revk/ESP32-EnvMon/PCB/Env2/README.md

# EnvMon

These files are for use in [KiCad](https://www.kicad.org).

## Trademark

This is an open source project, but bear in mind you cannot sell boards bearing the Andrews & Arnold Ltd name, the A&A logo, the registered trademark AJK logo, or the GS1 allocated EANs assigned to Andrews & Arnold Ltd.

## Images

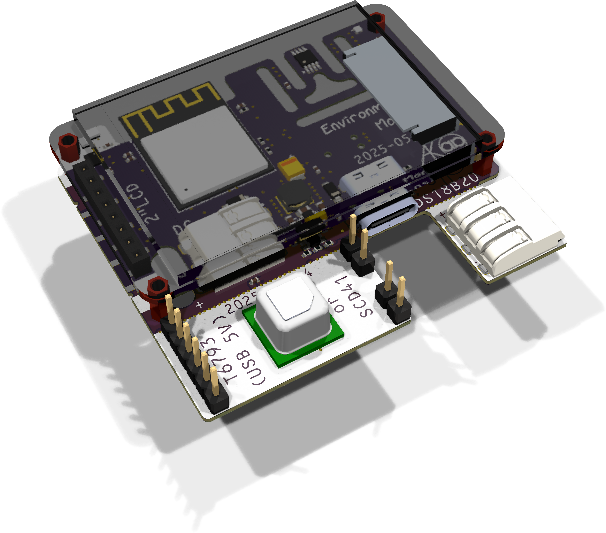
[picture p1: PCB/Env2/EnvMon.png]
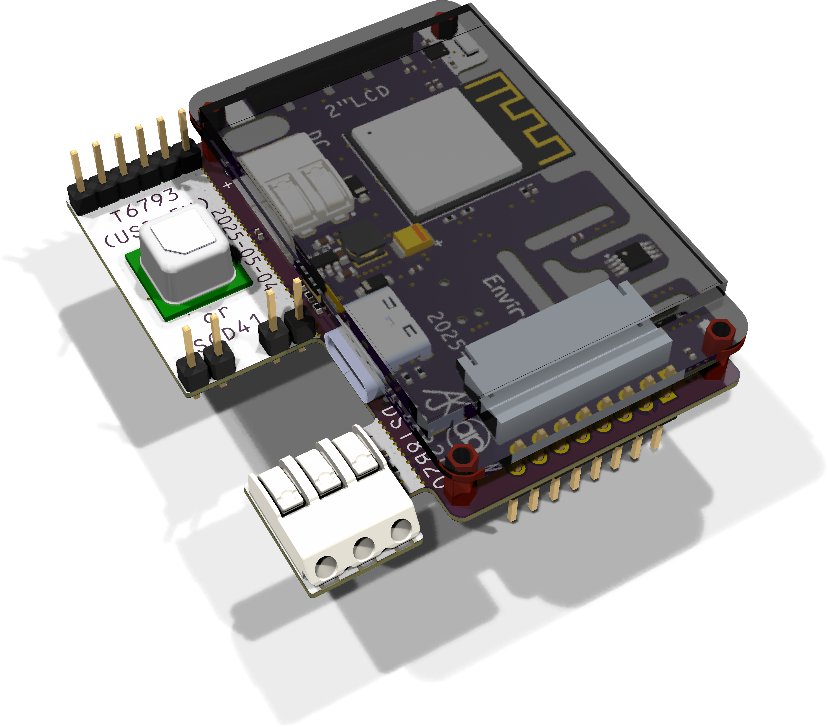
[picture p2: PCB/Env2/EnvMon-90.png]
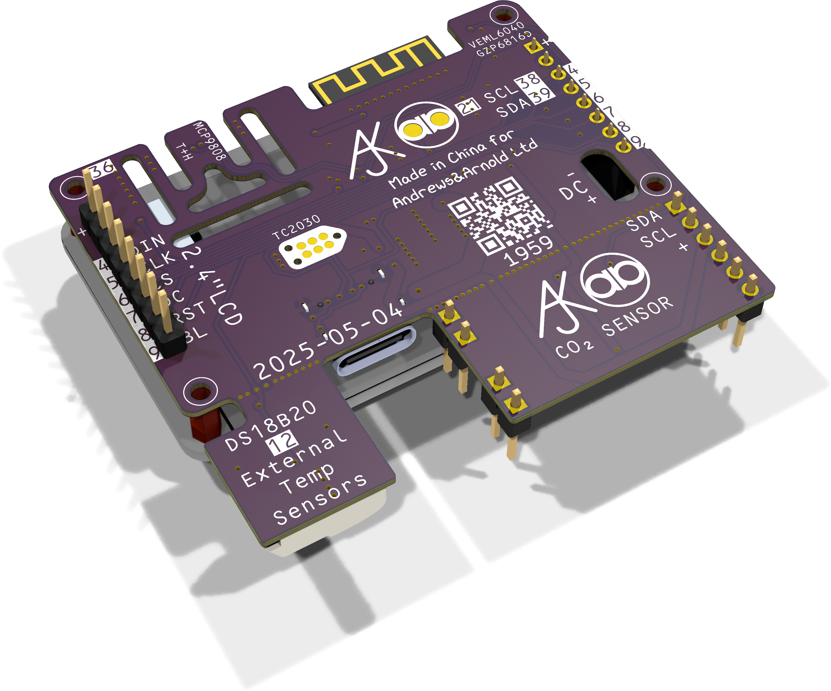
[picture p3: PCB/Env2/EnvMon-bottom.png]

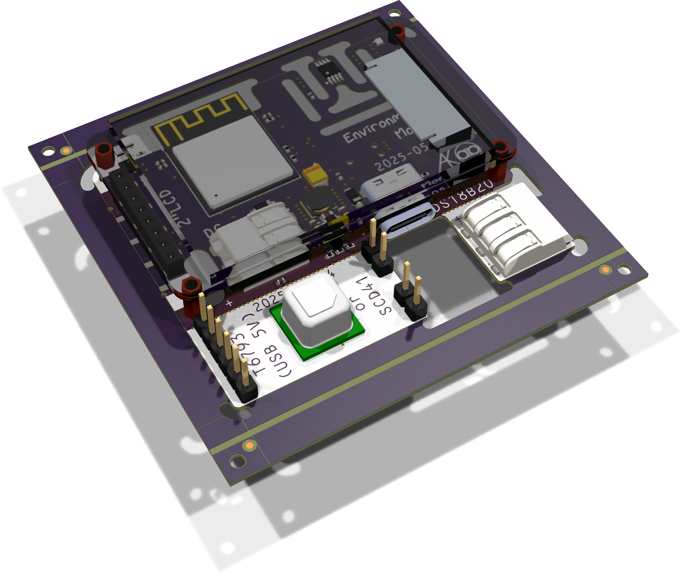
[picture p4: PCB/Env2/EnvMon-panel.png]
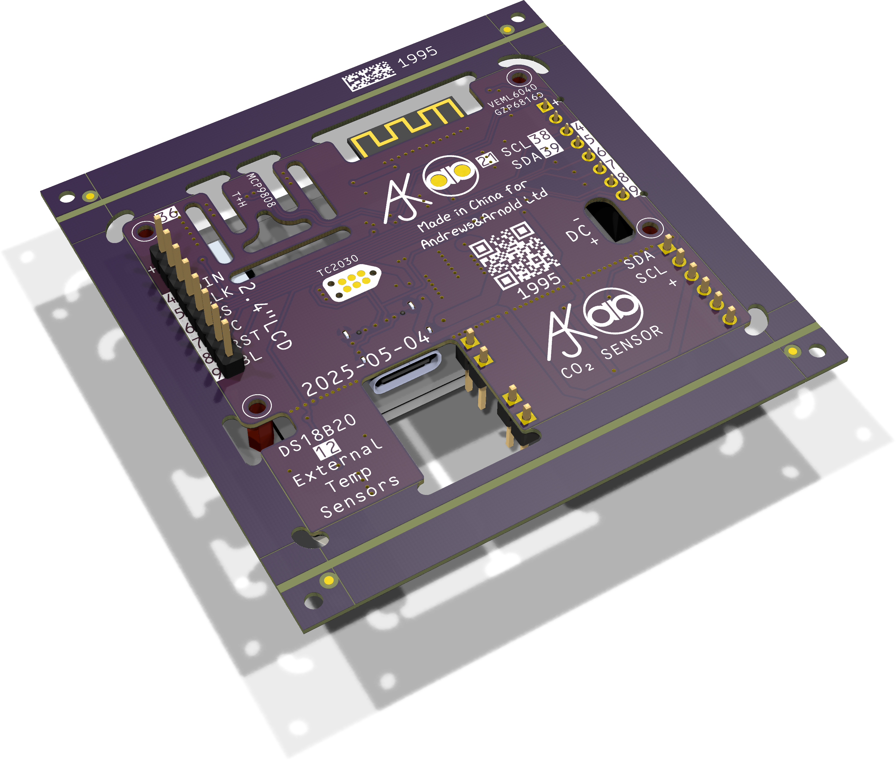
[picture p5: PCB/Env2/EnvMon-panel-bottom.png]


*Auto generated 2025-05-04T08:00:31*
