revk/ESP32-EnvMon/PCB/EnvHT/README.md

# EnvHT

These files are for use in [KiCad](https://www.kicad.org).

## Trademark

This is an open source project, but bear in mind you cannot sell boards bearing the Andrews & Arnold Ltd name, the A&A logo, the registered trademark AJK logo, or the GS1 allocated EANs assigned to Andrews & Arnold Ltd.

## Images

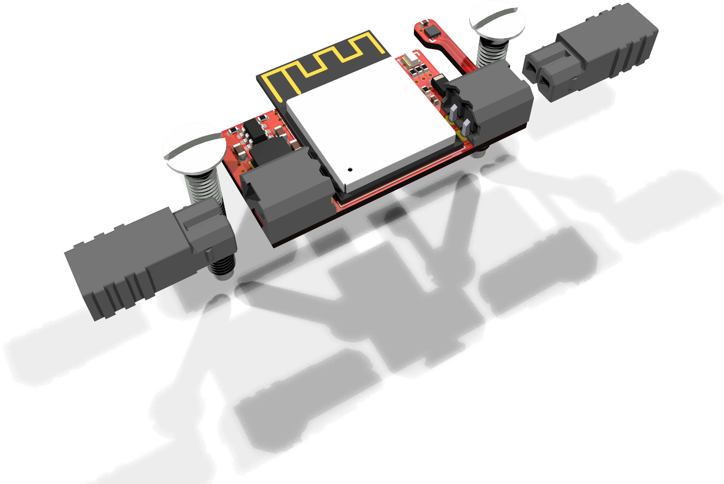
[picture p6: PCB/EnvHT/EnvHT.png]
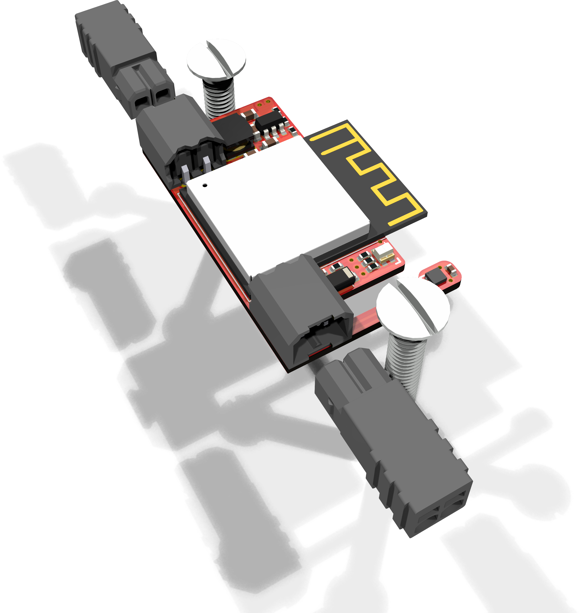
[picture p7: PCB/EnvHT/EnvHT-90.png]
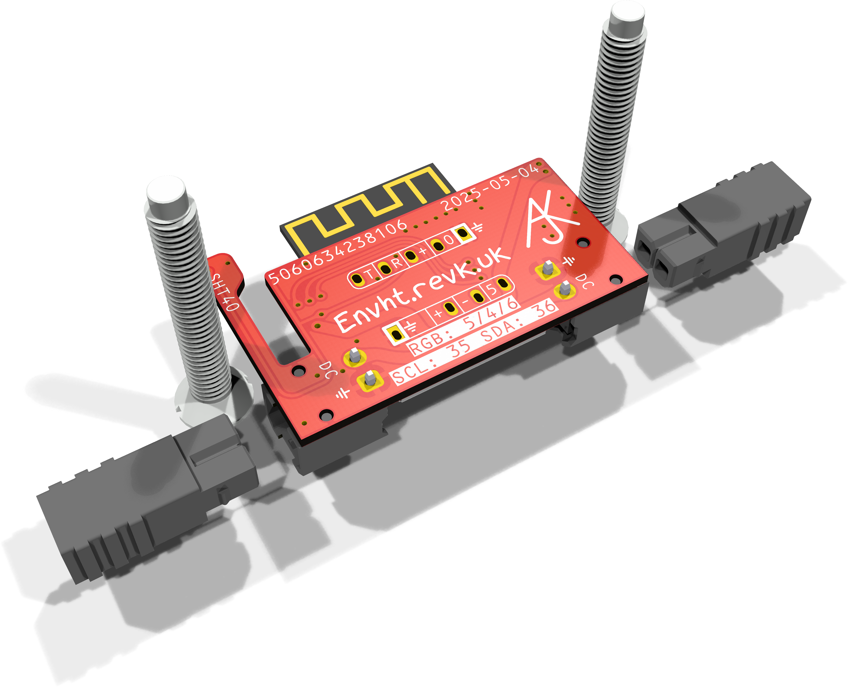
[picture p8: PCB/EnvHT/EnvHT-bottom.png]

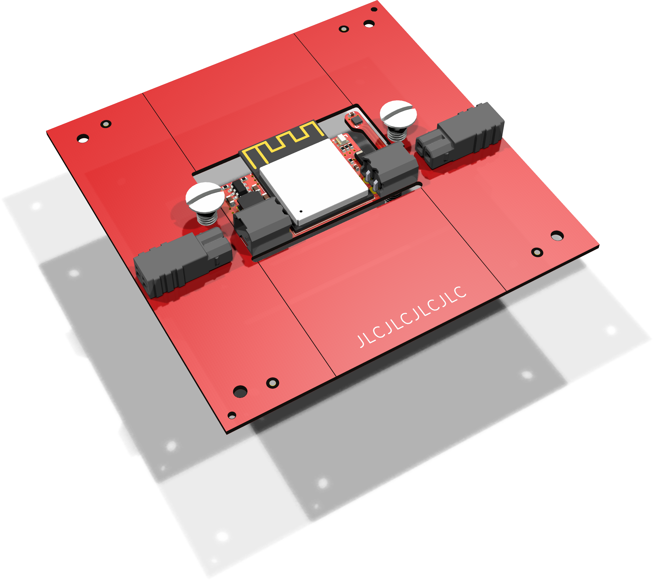
[picture p9: PCB/EnvHT/EnvHT-panel.png]
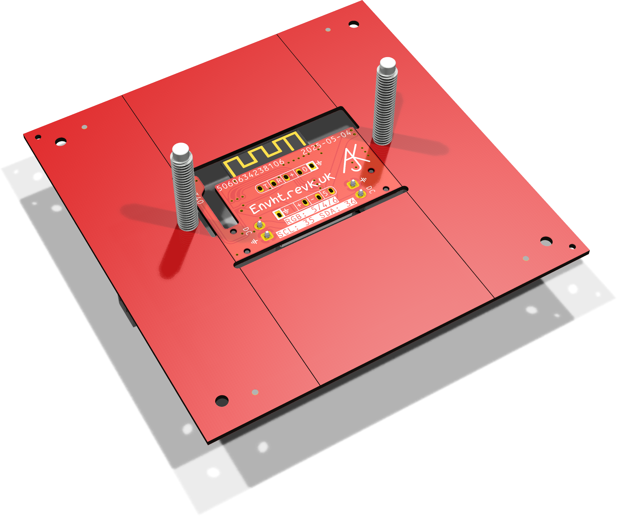
[picture p10: PCB/EnvHT/EnvHT-panel-bottom.png]


*Auto generated 2025-05-04T08:03:03*
