revk/ESP32-EnvMon/PCB/EnvMon/README.md

# EnvMon

These files are for use in [KiCad](https://www.kicad.org).

## Trademark

This is an open source project, but bear in mind you cannot sell boards bearing the Andrews & Arnold Ltd name, the A&A logo, the registered trademark AJK logo, or the GS1 allocated EANs assigned to Andrews & Arnold Ltd.

## Images

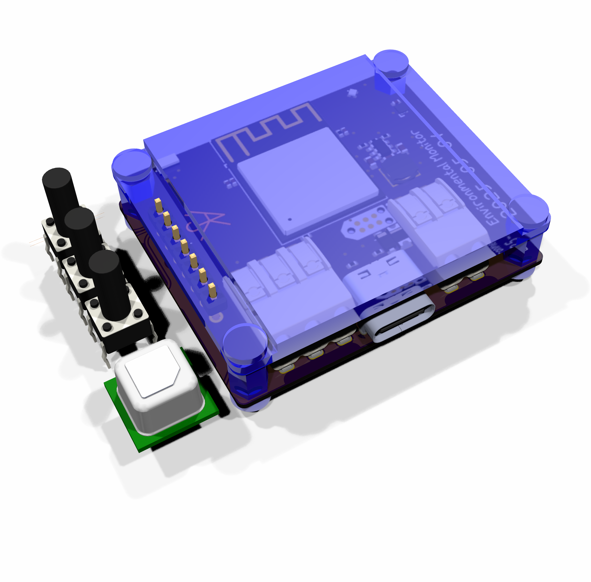
[picture p11: PCB/EnvMon/EnvMon.png]
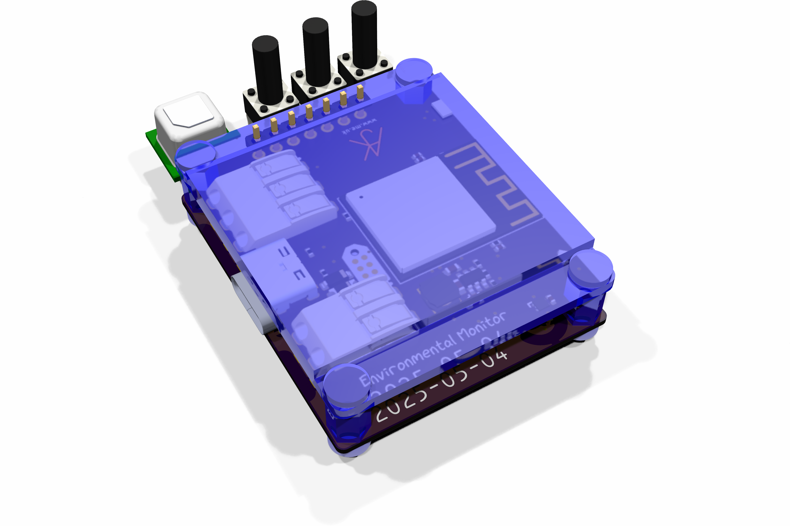
[picture p12: PCB/EnvMon/EnvMon-90.png]

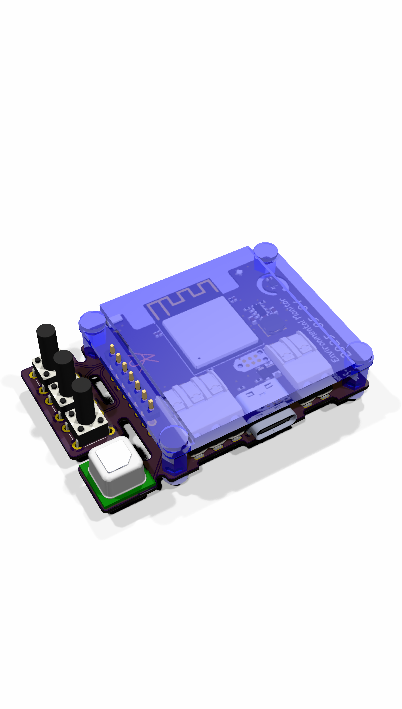
[picture p13: PCB/EnvMon/EnvMon-panel.png]


*Auto generated 2025-05-04T08:05:16*
