revk/ESP32-EnvMon/PCB/Env2/EnvMon.stl

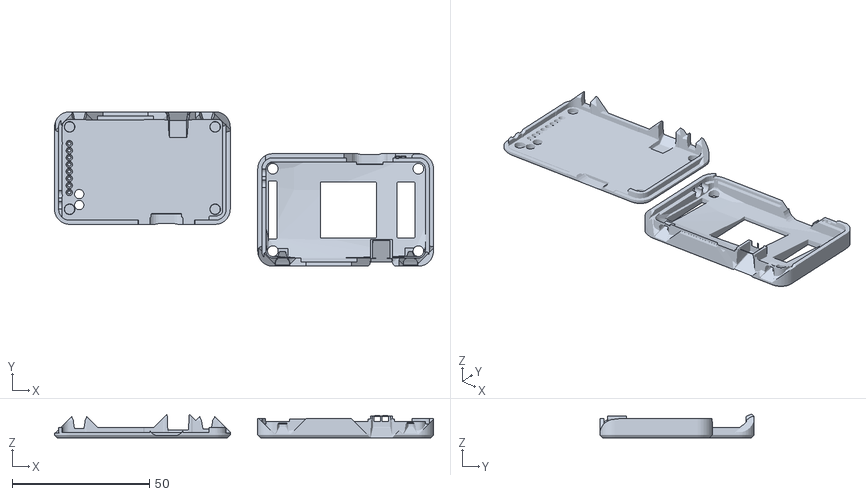
[picture p20: CAD file, 2025-05-06]
PCB/Env2/EnvMon.stl
138.0 x 56.2 x 8.59
