revk/ESP32-EnvMon/PCB/EnvHT/EnvHT.stl

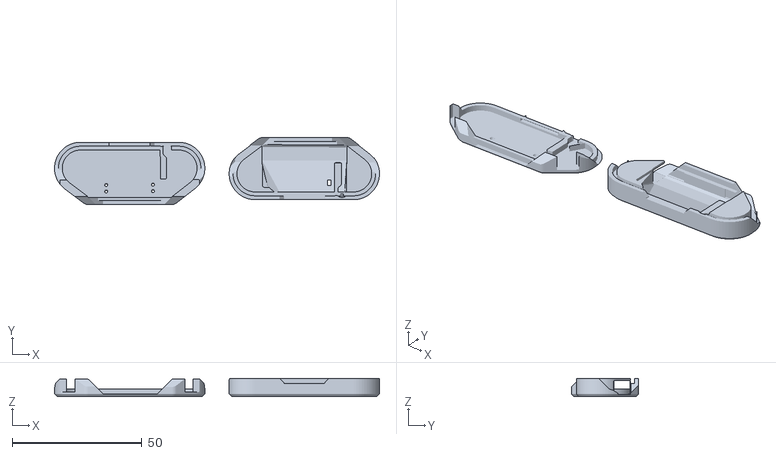
[picture p21: CAD file, 2025-05-06]
PCB/EnvHT/EnvHT.stl
125.3 x 25.9 x 6.99
