revk/ESP32-EnvMon/PCB/EnvMon/EnvMon-flush.stl

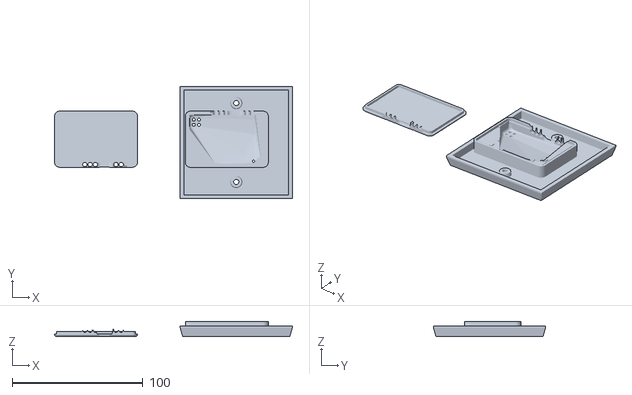
[picture p22: CAD file, 2025-05-06]
PCB/EnvMon/EnvMon-flush.stl
182.0 x 86.0 x 11.4
