revk/ESP32-EnvMon/PCB/USBC/USBC.stl

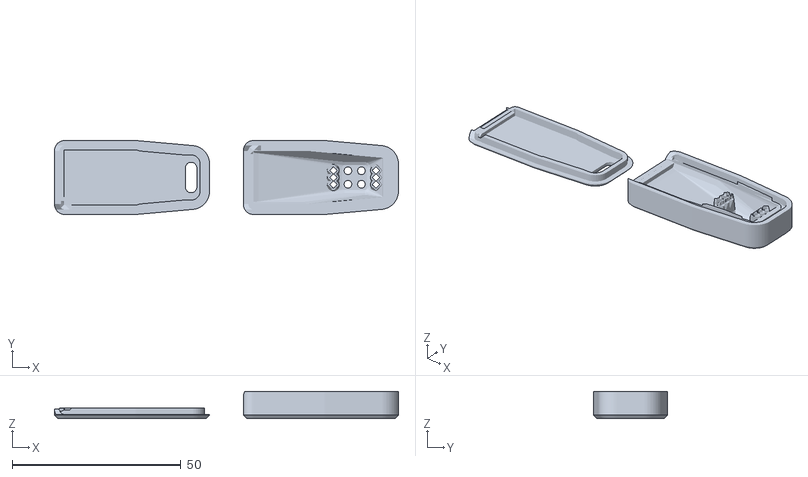
[picture p23: CAD file, 2025-05-06]
PCB/USBC/USBC.stl
102.0 x 21.9 x 8.06
