revk/ESP32-EnvMon/PCB/Env2-BP24.stl

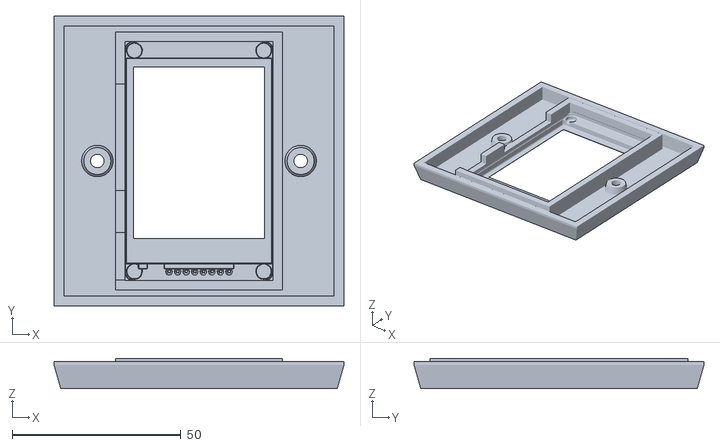
[picture p24: CAD file, 2025-05-06]
PCB/Env2-BP24.stl
86.0 x 86.0 x 9.00
