revk/ESP32-EnvMon/PCB/Env2/EnvMonBlind.stl

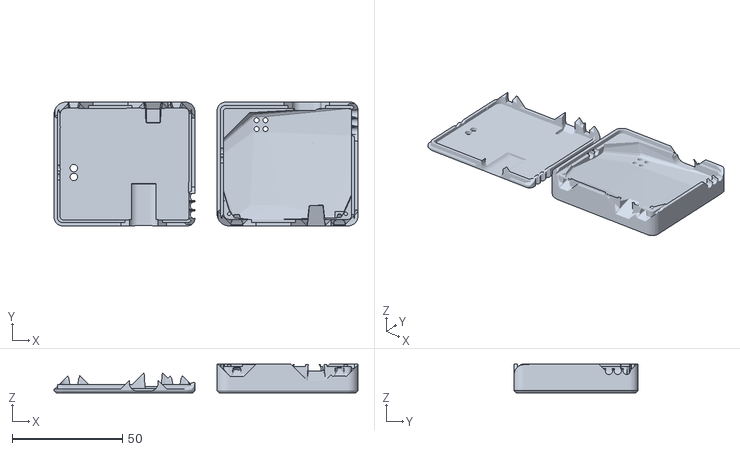
[picture p25: CAD file, 2025-05-06]
PCB/Env2/EnvMonBlind.stl
138.0 x 56.2 x 13.0
