revk/ESP32-EnvMon/PCB/EnvMon/EnvMon-noco2.stl

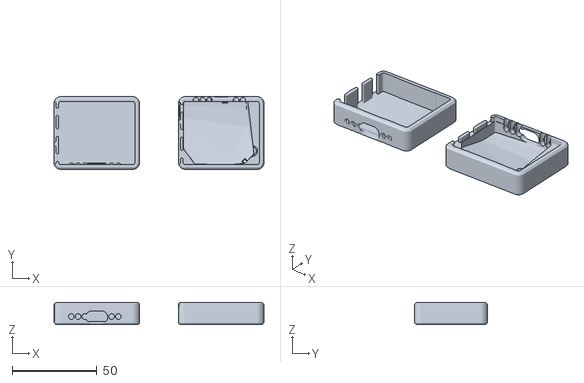
[picture p26: CAD file, 2025-05-06]
PCB/EnvMon/EnvMon-noco2.stl
124.0 x 43.0 x 13.2
