revk/ESP32-EnvMon/PCB/Env2-BP.stl

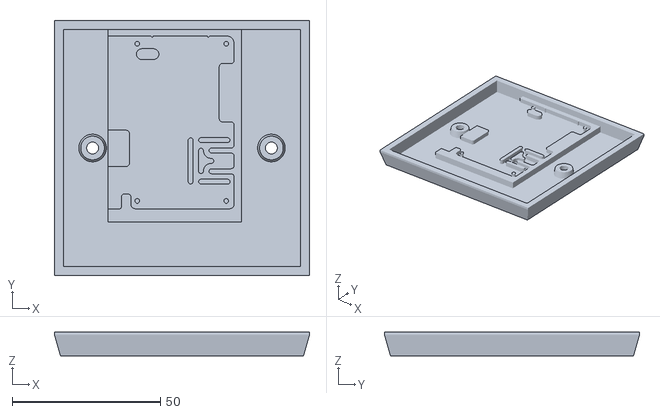
[picture p27: CAD file, 2025-05-06]
PCB/Env2-BP.stl
86.0 x 86.0 x 8.00
