revk/ESP32-EnvMon/PCB/Env2/EnvMonCO2.stl

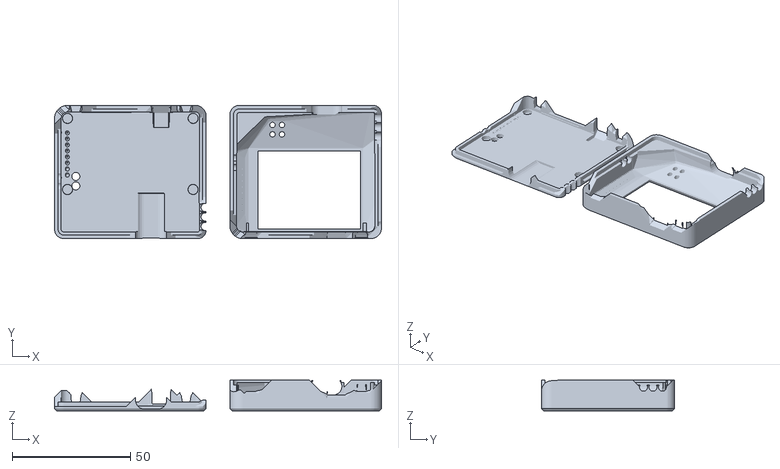
[picture p28: CAD file, 2025-05-06]
PCB/Env2/EnvMonCO2.stl
138.0 x 56.2 x 13.0
