revk/ESP32-EnvMon/PCB/EnvMon/EnvMon.stl

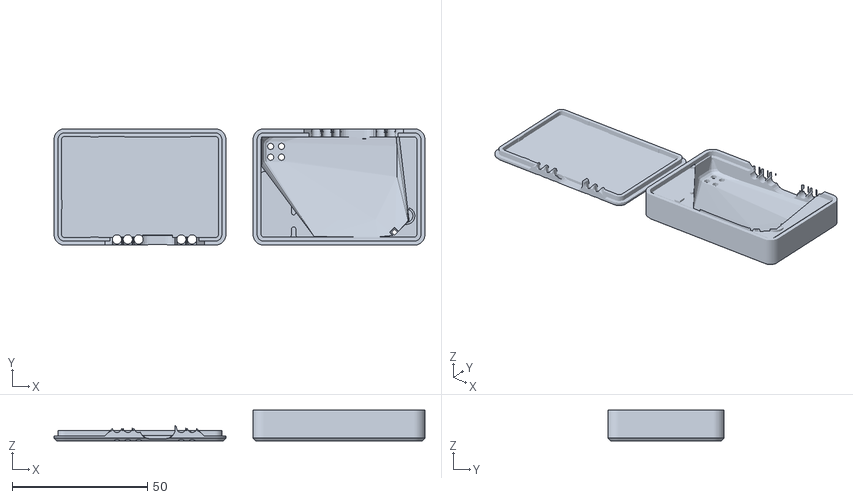
[picture p29: CAD file, 2025-05-06]
PCB/EnvMon/EnvMon.stl
137.0 x 43.0 x 11.4
