revk/ESP32-EnvMon/PCB/EnvMon/EnvMon-nooled.stl

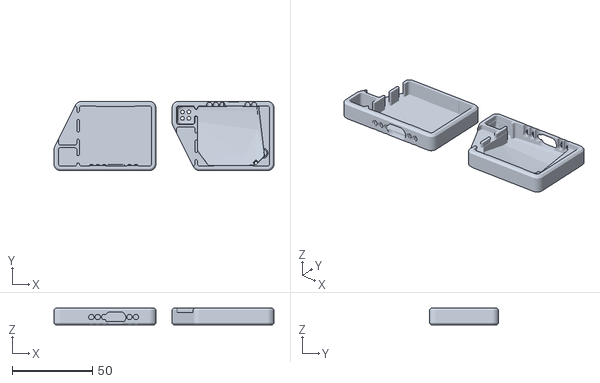
[picture p30: CAD file, 2025-05-06]
PCB/EnvMon/EnvMon-nooled.stl
137.0 x 43.0 x 10.3
