revk/ESP32-EnvMon/PCB/EnvMon/EnvMon-flush-nooled.stl

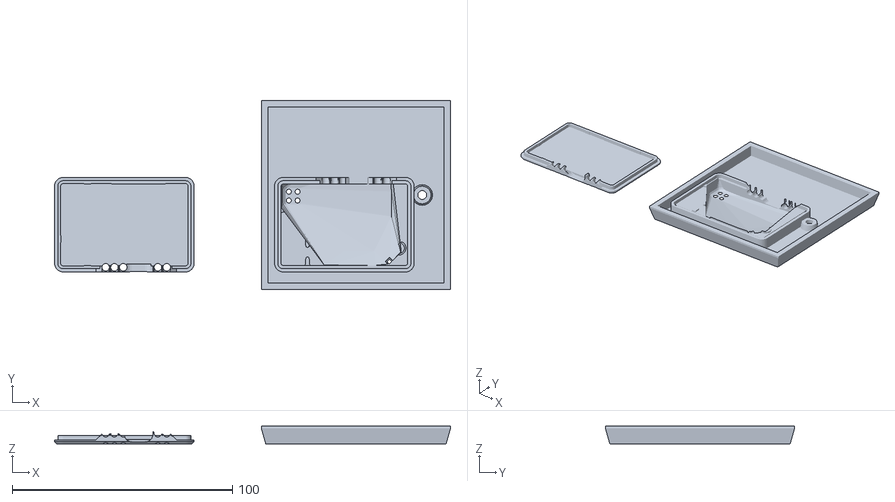
[picture p31: CAD file, 2025-05-06]
PCB/EnvMon/EnvMon-flush-nooled.stl
180.0 x 86.0 x 8.00
