revk/ESP32-EnvMon/PCB/Env2-CoverDS.stl

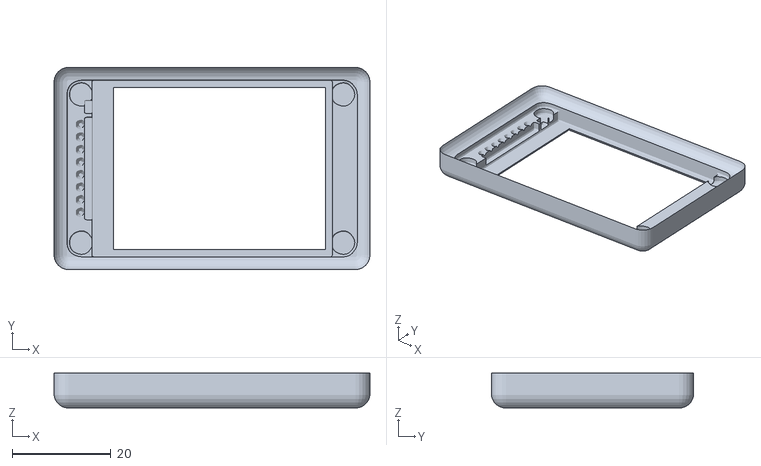
[picture p32: CAD file, 2025-05-03]
PCB/Env2-CoverDS.stl
63.9 x 40.9 x 7.08
