revk/ESP32-EnvMon/PCB/EnvMon/EnvMon-flush-noco2.stl

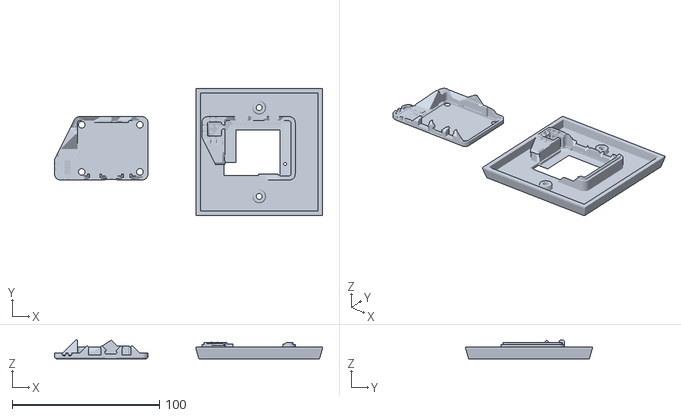
[picture p33: CAD file, 2023-12-11]
PCB/EnvMon/EnvMon-flush-noco2.stl
182.0 x 86.0 x 12.8
