revk/ESP32-EnvMon/PCB/Env2-CoverCO2.stl

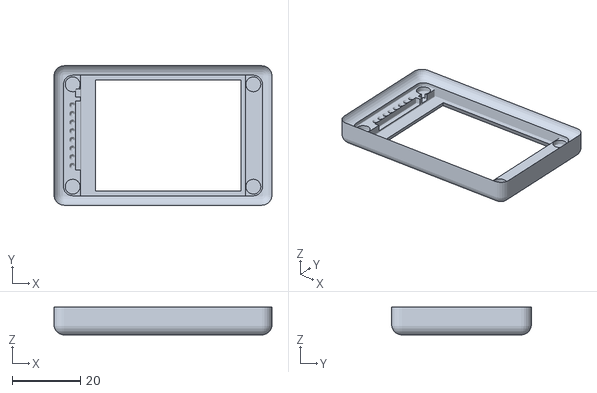
[picture p34: CAD file, 2025-05-03]
PCB/Env2-CoverCO2.stl
63.9 x 40.9 x 8.08
