revk/ESP32-EnvMon/PCB/lcd2.stl

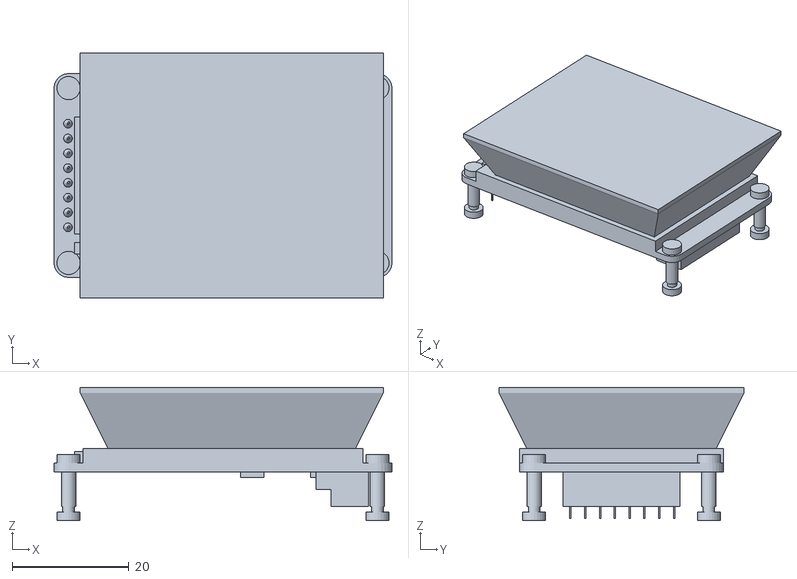
[picture p35: CAD file, 2025-05-02]
PCB/lcd2.stl
58.0 x 42.0 x 22.9
