revk/ESP32-EnvMon/PCB/Env2-Cover2.stl

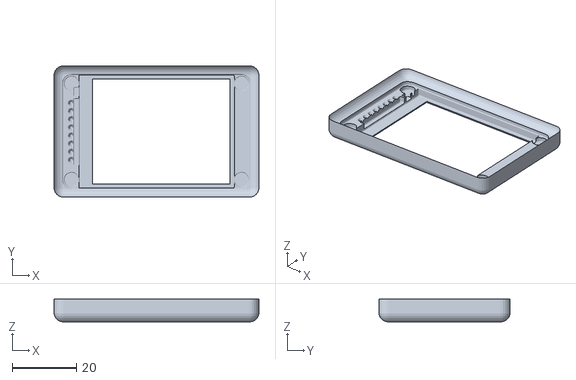
[picture p36: CAD file, 2025-04-28]
PCB/Env2-Cover2.stl
63.9 x 40.9 x 7.08
