revk/ESP32-EnvMon/PCB/lcd24.stl

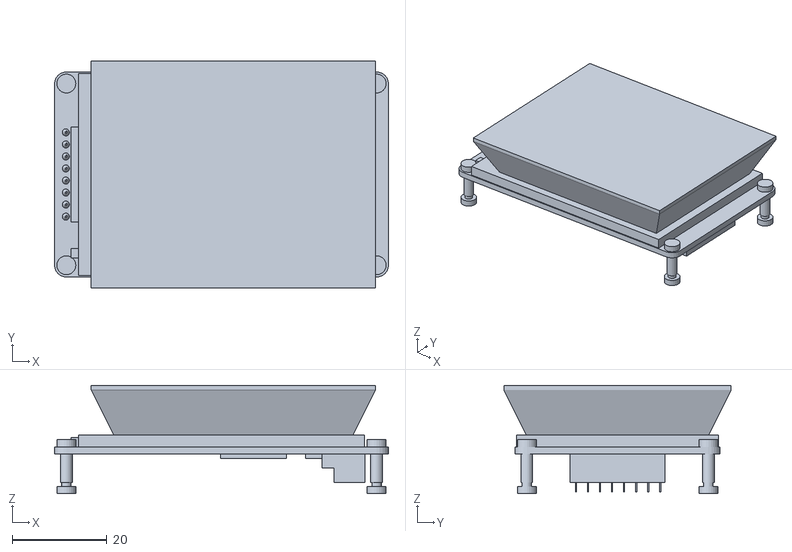
[picture p37: CAD file, 2025-04-27]
PCB/lcd24.stl
70.5 x 48.0 x 22.9
