revk/ESP32-EnvMon/PCB/blankplate.stl

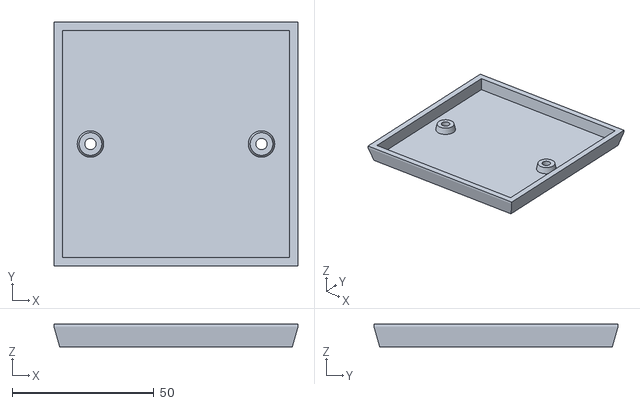
[picture p38: CAD file, 2025-04-27]
PCB/blankplate.stl
86.0 x 86.0 x 8.00
