revk/ESP32-EnvMon/PCB/Env2/EnvMon.scad

// Generated case design for Env2/EnvMon.kicad_pcb
// By https://github.com/revk/PCBCase
// Generated 2025-05-05 10:25:44
// title:	Env2
// comment:	www.me.uk
// comment:	@TheRealRevK
// comment:	Adrian Kennard Andrews & Arnold Ltd
//

// Globals
margin=0.200000;
lip=2.000000;
casebottom=2.000000;
casetop=6.000000;
casewall=3.000000;
fit=0.000000;
edge=1.000000;
pcbthickness=0.800000;
nohull=false;
hullcap=1.000000;
hulledge=1.000000;
useredge=true;

module outline(h=pcbthickness,r=0){linear_extrude(height=h)offset(r=r)polygon(points=[[0.000000,47.750000],[0.000000,17.750000],[0.062680,17.193698],[0.247578,16.665291],[0.545421,16.191275],[0.941275,15.795421],[1.415291,15.497578],[1.943698,15.312680],[2.500000,15.250000],[55.500000,15.250000],[56.056302,15.312680],[56.584709,15.497578],[57.058725,15.795421],[57.454579,16.191275],[57.752422,16.665291],[57.937320,17.193698],[58.000000,17.750000],[58.000000,47.750000],[57.937320,48.306302],[57.752422,48.834709],[57.454579,49.308725],[57.058725,49.704579],[56.584709,50.002422],[56.056302,50.187320],[55.500000,50.250000],[2.500000,50.250000],[1.943698,50.187320],[1.415291,50.002422],[0.941275,49.704579],[0.545421,49.308725],[0.247578,48.834709],[0.062680,48.306302]],paths=[[0,1,2,3,4,5,6,7,8,9,10,11,12,13,14,15,16,17,18,19,20,21,22,23,24,25,26,27,28,29,30,31]]);}

module pcb(h=pcbthickness,r=0){linear_extrude(height=h)offset(r=r)polygon(points=[[58.000000,17.250000],[58.000000,48.750000],[57.926585,49.213525],[57.713525,49.631678],[57.381678,49.963525],[56.963525,50.176585],[56.500000,50.250000],[47.500000,50.250000],[47.117316,50.173880],[46.792893,49.957107],[46.576120,49.632684],[46.500000,49.250000],[46.500000,42.750000],[46.465926,42.491181],[46.366025,42.250000],[46.207107,42.042893],[46.000000,41.883975],[45.758819,41.784074],[45.500000,41.750000],[45.241181,41.784074],[45.000000,41.883975],[44.792893,42.042893],[44.633975,42.250000],[44.534074,42.491181],[44.500000,42.750000],[44.500000,49.250000],[44.423880,49.632684],[44.207107,49.957107],[43.882684,50.173880],[43.500000,50.250000],[40.500000,50.250000],[40.117316,50.173880],[39.792893,49.957107],[39.576120,49.632684],[39.500000,49.250000],[39.500000,42.750000],[39.465926,42.491181],[39.366025,42.250000],[39.207107,42.042893],[39.000000,41.883975],[38.758819,41.784074],[38.500000,41.750000],[38.241181,41.784074],[38.000000,41.883975],[37.792893,42.042893],[37.633975,42.250000],[37.534074,42.491181],[37.500000,42.750000],[37.500000,49.250000],[37.423880,49.632684],[37.207107,49.957107],[36.882684,50.173880],[36.500000,50.250000],[30.000000,50.250000],[29.617316,50.173880],[29.292893,49.957107],[29.076120,49.632684],[29.000000,49.250000],[29.000000,46.250000],[28.965926,45.991181],[28.866026,45.750000],[28.707107,45.542893],[28.500000,45.383974],[28.258819,45.284074],[28.000000,45.250000],[10.000000,45.250000],[9.741181,45.284074],[9.500000,45.383974],[9.292893,45.542893],[9.133974,45.750000],[9.034074,45.991181],[9.000000,46.250000],[9.000000,49.250000],[8.923880,49.632684],[8.707107,49.957107],[8.382684,50.173880],[8.000000,50.250000],[2.500000,50.250000],[1.943698,50.187320],[1.415291,50.002422],[0.941275,49.704579],[0.545421,49.308725],[0.247578,48.834709],[0.062680,48.306302],[0.000000,47.750000],[0.000000,42.250000],[0.191342,42.211940],[0.353553,42.103553],[0.461940,41.941342],[0.500000,41.750000],[0.461940,41.558658],[0.353553,41.396447],[0.191342,41.288060],[0.000000,41.250000],[0.000000,23.250000],[0.191342,23.211940],[0.353553,23.103553],[0.461940,22.941342],[0.500000,22.750000],[0.461940,22.558658],[0.353553,22.396447],[0.191342,22.288060],[0.000000,22.250000],[0.000000,1.000000],[0.076120,0.617316],[0.292893,0.292893],[0.617316,0.076120],[1.000000,0.000000],[31.000000,0.000000],[31.353553,0.146447],[31.500000,0.500000],[31.500000,14.250000],[31.534074,14.508819],[31.633974,14.750000],[31.792893,14.957107],[32.000000,15.116026],[32.241181,15.215926],[32.500000,15.250000],[43.000000,15.250000],[43.258819,15.215926],[43.500000,15.116026],[43.707107,14.957107],[43.866026,14.750000],[43.965926,14.508819],[44.000000,14.250000],[44.000000,0.500000],[44.146447,0.146447],[44.500000,0.000000],[57.500000,0.000000],[57.853553,0.146447],[58.000000,0.500000],[58.000000,11.750000],[57.853553,12.103553],[57.500000,12.250000],[54.000000,12.250000],[53.741181,12.284074],[53.500000,12.383974],[53.292893,12.542893],[53.133974,12.750000],[53.034074,12.991181],[53.000000,13.250000],[53.000000,14.750000],[53.034074,15.008819],[53.133974,15.250000],[53.292893,15.457107],[53.500000,15.616026],[53.741181,15.715926],[54.000000,15.750000],[56.500000,15.750000],[56.963525,15.823415],[57.381678,16.036475],[57.713525,16.368322],[57.926585,16.786475],[56.500000,17.750000],[56.465926,17.491181],[56.366025,17.250000],[56.207107,17.042893],[56.000000,16.883975],[55.758819,16.784074],[55.500000,16.750000],[55.241181,16.784074],[55.000000,16.883975],[54.792893,17.042893],[54.633975,17.250000],[54.534074,17.491181],[54.500000,17.750000],[54.534074,18.008819],[54.633975,18.250000],[54.792893,18.457107],[55.000000,18.616025],[55.241181,18.715926],[55.500000,18.750000],[55.758819,18.715926],[56.000000,18.616025],[56.207107,18.457107],[56.366025,18.250000],[56.465926,18.008819],[49.000000,34.750000],[49.309017,34.798943],[49.587785,34.940983],[49.809017,35.162215],[49.951057,35.440983],[50.000000,35.750000],[49.951057,36.059017],[49.809017,36.337785],[49.587785,36.559017],[49.309017,36.701057],[49.000000,36.750000],[35.000000,36.750000],[34.690983,36.701057],[34.412215,36.559017],[34.190983,36.337785],[34.048943,36.059017],[34.000000,35.750000],[34.048943,35.440983],[34.190983,35.162215],[34.412215,34.940983],[34.690983,34.798943],[35.000000,34.750000],[48.000000,39.250000],[48.000000,48.250000],[48.034074,48.508819],[48.133975,48.750000],[48.292893,48.957107],[48.500000,49.116025],[48.741181,49.215926],[49.000000,49.250000],[49.258819,49.215926],[49.500000,49.116025],[49.707107,48.957107],[49.866025,48.750000],[49.965926,48.508819],[50.000000,48.250000],[50.000000,39.250000],[49.965926,38.991181],[49.866025,38.750000],[49.707107,38.542893],[49.500000,38.383975],[49.258819,38.284074],[49.000000,38.250000],[48.741181,38.284074],[48.500000,38.383975],[48.292893,38.542893],[48.133975,38.750000],[48.034074,38.991181],[45.500000,38.250000],[38.500000,38.250000],[38.241181,38.284074],[38.000000,38.383975],[37.792893,38.542893],[37.633975,38.750000],[37.534074,38.991181],[37.500000,39.250000],[37.534074,39.508819],[37.633975,39.750000],[37.792893,39.957107],[38.000000,40.116025],[38.241181,40.215926],[38.500000,40.250000],[39.056302,40.312680],[39.584709,40.497578],[40.058725,40.795421],[40.454579,41.191275],[40.752422,41.665291],[40.937320,42.193698],[41.000000,42.750000],[41.034074,43.008819],[41.133975,43.250000],[41.292893,43.457107],[41.500000,43.616025],[41.741181,43.715926],[42.000000,43.750000],[42.258819,43.715926],[42.500000,43.616025],[42.707107,43.457107],[42.866025,43.250000],[42.965926,43.008819],[43.000000,42.750000],[43.062680,42.193698],[43.247578,41.665291],[43.545421,41.191275],[43.941275,40.795421],[44.415291,40.497578],[44.943698,40.312680],[45.500000,40.250000],[45.758819,40.215926],[46.000000,40.116025],[46.207107,39.957107],[46.366025,39.750000],[46.465926,39.508819],[46.500000,39.250000],[46.465926,38.991181],[46.366025,38.750000],[46.207107,38.542893],[46.000000,38.383975],[45.758819,38.284074],[36.000000,39.250000],[36.000000,48.250000],[35.951057,48.559017],[35.809017,48.837785],[35.587785,49.059017],[35.309017,49.201057],[35.000000,49.250000],[34.690983,49.201057],[34.412215,49.059017],[34.190983,48.837785],[34.048943,48.559017],[34.000000,48.250000],[34.000000,39.250000],[34.048943,38.940983],[34.190983,38.662215],[34.412215,38.440983],[34.690983,38.298943],[35.000000,38.250000],[35.309017,38.298943],[35.587785,38.440983],[35.809017,38.662215],[35.951057,38.940983],[54.500000,47.750000],[54.534074,48.008819],[54.633975,48.250000],[54.792893,48.457107],[55.000000,48.616025],[55.241181,48.715926],[55.500000,48.750000],[55.758819,48.715926],[56.000000,48.616025],[56.207107,48.457107],[56.366025,48.250000],[56.465926,48.008819],[56.500000,47.750000],[56.465926,47.491181],[56.366025,47.250000],[56.207107,47.042893],[56.000000,46.883975],[55.758819,46.784074],[55.500000,46.750000],[55.241181,46.784074],[55.000000,46.883975],[54.792893,47.042893],[54.633975,47.250000],[54.534074,47.491181],[3.500000,47.750000],[3.465926,47.491181],[3.366025,47.250000],[3.207107,47.042893],[3.000000,46.883975],[2.758819,46.784074],[2.500000,46.750000],[2.241181,46.784074],[2.000000,46.883975],[1.792893,47.042893],[1.633975,47.250000],[1.534074,47.491181],[1.500000,47.750000],[1.534074,48.008819],[1.633975,48.250000],[1.792893,48.457107],[2.000000,48.616025],[2.241181,48.715926],[2.500000,48.750000],[2.758819,48.715926],[3.000000,48.616025],[3.207107,48.457107],[3.366025,48.250000],[3.465926,48.008819],[4.000000,23.250000],[4.000000,19.250000],[4.050144,18.804958],[4.198062,18.382233],[4.436337,18.003020],[4.753020,17.686337],[5.132233,17.448062],[5.554958,17.300144],[6.000000,17.250000],[6.445042,17.300144],[6.867767,17.448062],[7.246980,17.686337],[7.563663,18.003020],[7.801938,18.382233],[7.949856,18.804958],[8.000000,19.250000],[8.000000,23.250000],[7.949856,23.695042],[7.801938,24.117767],[7.563663,24.496980],[7.246980,24.813663],[6.867767,25.051938],[6.445042,25.199856],[6.000000,25.250000],[5.554958,25.199856],[5.132233,25.051938],[4.753020,24.813663],[4.436337,24.496980],[4.198062,24.117767],[4.050144,23.695042],[3.500000,17.750000],[3.465926,17.491181],[3.366025,17.250000],[3.207107,17.042893],[3.000000,16.883975],[2.758819,16.784074],[2.500000,16.750000],[2.241181,16.784074],[2.000000,16.883975],[1.792893,17.042893],[1.633975,17.250000],[1.534074,17.491181],[1.500000,17.750000],[1.534074,18.008819],[1.633975,18.250000],[1.792893,18.457107],[2.000000,18.616025],[2.241181,18.715926],[2.500000,18.750000],[2.758819,18.715926],[3.000000,18.616025],[3.207107,18.457107],[3.366025,18.250000],[3.465926,18.008819]],paths=[[0,1,2,3,4,5,6,7,8,9,10,11,12,13,14,15,16,17,18,19,20,21,22,23,24,25,26,27,28,29,30,31,32,33,34,35,36,37,38,39,40,41,42,43,44,45,46,47,48,49,50,51,52,53,54,55,56,57,58,59,60,61,62,63,64,65,66,67,68,69,70,71,72,73,74,75,76,77,78,79,80,81,82,83,84,85,86,87,88,89,90,91,92,93,94,95,96,97,98,99,100,101,102,103,104,105,106,107,108,109,110,111,112,113,114,115,116,117,118,119,120,121,122,123,124,125,126,127,128,129,130,131,132,133,134,135,136,137,138,139,140,141,142,143,144,145,146,147,148,149,150,151,152],[153,154,155,156,157,158,159,160,161,162,163,164,165,166,167,168,169,170,171,172,173,174,175,176],[177,178,179,180,181,182,183,184,185,186,187,188,189,190,191,192,193,194,195,196,197,198],[199,200,201,202,203,204,205,206,207,208,209,210,211,212,213,214,215,216,217,218,219,220,221,222,223,224],[225,226,227,228,229,230,231,232,233,234,235,236,237,238,239,240,241,242,243,244,245,246,247,248,249,250,251,252,253,254,255,256,257,258,259,260,261,262,263,264,265,266,267,268,269,270,271,272,273,274,275],[276,277,278,279,280,281,282,283,284,285,286,287,288,289,290,291,292,293,294,295,296,297],[298,299,300,301,302,303,304,305,306,307,308,309,310,311,312,313,314,315,316,317,318,319,320,321],[322,323,324,325,326,327,328,329,330,331,332,333,334,335,336,337,338,339,340,341,342,343,344,345],[346,347,348,349,350,351,352,353,354,355,356,357,358,359,360,361,362,363,364,365,366,367,368,369,370,371,372,373,374,375],[376,377,378,379,380,381,382,383,384,385,386,387,388,389,390,391,392,393,394,395,396,397,398,399]]);}
spacing=74.000000;
pcbwidth=58.000000;
pcblength=50.250000;
// Parts to go on PCB (top)
module parts_top(part=false,hole=false,block=false){
translate([54.500000,45.250000,0.800000])m0(part,hole,block,casetop); // RevK:C_0402 C_0402_1005Metric (back)
translate([28.300000,16.800000,0.800000])rotate([0,0,180.000000])m1(part,hole,block,casetop); // RevK:R_0402_ R_0402_1005Metric (back)
translate([43.500000,18.750000,0.800000])m1(part,hole,block,casetop); // RevK:R_0402_ R_0402_1005Metric (back)
translate([24.699999,16.800000,0.800000])rotate([0,0,180.000000])m1(part,hole,block,casetop); // RevK:R_0402_ R_0402_1005Metric (back)
translate([29.000000,20.000000,0.800000])rotate([0,0,-90.000000])m2(part,hole,block,casetop); // RevK:C_0603_ C_0603_1608Metric (back)
translate([6.000000,48.750000,0.800000])m3(part,hole,block,casetop); // U8 (back)
translate([28.500000,43.250000,0.800000])m0(part,hole,block,casetop); // RevK:C_0402 C_0402_1005Metric (back)
translate([3.000000,45.250000,0.800000])rotate([0,0,-90.000000])m0(part,hole,block,casetop); // RevK:C_0402 C_0402_1005Metric (back)
translate([9.500000,42.750000,0.800000])rotate([0,0,180.000000])m0(part,hole,block,casetop); // RevK:C_0402 C_0402_1005Metric (back)
translate([28.500000,42.250000,0.800000])rotate([0,0,180.000000])m1(part,hole,block,casetop); // RevK:R_0402_ R_0402_1005Metric (back)
translate([27.750000,35.500000,0.800000])rotate([0,0,-90.000000])m1(part,hole,block,casetop); // RevK:R_0402_ R_0402_1005Metric (back)
translate([24.000000,20.000000,0.800000])rotate([0,0,-90.000000])m2(part,hole,block,casetop); // RevK:C_0603_ C_0603_1608Metric (back)
translate([7.700000,45.850000,0.800000])rotate([0,0,180.000000])m0(part,hole,block,casetop); // RevK:C_0402 C_0402_1005Metric (back)
translate([47.900000,13.550000,0.800000])rotate([0,0,180.000000])m0(part,hole,block,casetop); // RevK:C_0402 C_0402_1005Metric (back)
translate([29.000000,32.750000,0.800000])translate([-26.600000,8.890000,0.000000])scale([1.000000,1.000000,0.700000])m4(part,hole,block,casetop,08); // RevK:LCD2 PinSocket_1x08_P2.54mm_Vertical (back)
translate([29.000000,32.750000,0.800000])translate([-26.500000,15.000000,0.000000])m6(part,hole,block,casetop); // RevK:LCD2 M2x6Pillar (back)
translate([29.000000,32.750000,0.800000])translate([-26.500000,-15.000000,0.000000])m6(part,hole,block,casetop); // RevK:LCD2 M2x6Pillar (back)
translate([29.000000,32.750000,0.800000])translate([26.500000,15.000000,0.000000])m6(part,hole,block,casetop); // RevK:LCD2 M2x6Pillar (back)
translate([29.000000,32.750000,0.800000])translate([26.500000,-15.000000,0.000000])m6(part,hole,block,casetop); // RevK:LCD2 M2x6Pillar (back)
translate([29.000000,32.750000,0.800000])translate([22.000000,0.000000,0.000000])m7(part,hole,block,casetop); // RevK:LCD2 LCDHeader (back)
translate([9.500000,41.750000,0.800000])rotate([0,0,180.000000])m0(part,hole,block,casetop); // RevK:C_0402 C_0402_1005Metric (back)
translate([31.750000,21.750000,0.800000])rotate([0,0,90.000000])m8(part,hole,block,casetop); // D20 (back)
translate([26.500000,20.700000,0.800000])rotate([0,0,180.000000])m2(part,hole,block,casetop); // RevK:C_0603_ C_0603_1608Metric (back)
translate([16.000000,16.250000,0.800000])m0(part,hole,block,casetop); // RevK:C_0402 C_0402_1005Metric (back)
translate([50.550000,6.150000,0.800000])rotate([0,0,180.000000])m9(part,hole,block,casetop); // J3 (back)
translate([37.750000,21.250000,0.800000])translate([0.000000,-2.400000,0.000000])rotate([90.000000,-0.000000,-0.000000])m10(part,hole,block,casetop); // RevK:USB-C-Socket-H CSP-USC16-TR (back)
translate([28.700000,28.150000,0.800000])rotate([0,0,90.000000])m11(part,hole,block,casetop); // C4 (back)
translate([16.000000,21.250000,0.800000])m12(part,hole,block,casetop); // J2 (back)
translate([26.500000,18.700000,0.800000])rotate([0,0,180.000000])m13(part,hole,block,casetop); // RevK:SOT-23-6-MD8942 SOT-23-6 (back)
translate([50.000000,13.550000,0.800000])rotate([0,0,180.000000])m1(part,hole,block,casetop); // RevK:R_0402_ R_0402_1005Metric (back)
translate([5.000000,45.250000,0.800000])rotate([0,0,-90.000000])m14(part,hole,block,casetop); // U5 (back)
translate([26.500000,23.300000,0.800000])rotate([0,0,180.000000])scale([1.000000,1.000000,1.400000])rotate([0.000000,0.000000,-90.000000])m15(part,hole,block,casetop); // RevK:L_4x4_ TYA4020 (back)
translate([52.575000,48.675000,0.800000])m16(part,hole,block,casetop); // D4 (back)
translate([19.000000,37.250000,0.800000])m17(part,hole,block,casetop); // U1 (back)
translate([42.025000,47.000000,0.800000])rotate([0,0,90.000000])m18(part,hole,block,casetop); // U4 (back)
translate([19.000000,26.750000,0.800000])rotate([0,0,180.000000])m8(part,hole,block,casetop); // D20 (back)
translate([26.500000,16.800000,0.800000])rotate([0,0,180.000000])m1(part,hole,block,casetop); // RevK:R_0402_ R_0402_1005Metric (back)
translate([43.500000,20.250000,0.800000])m1(part,hole,block,casetop); // RevK:R_0402_ R_0402_1005Metric (back)
translate([36.750000,43.500000,0.800000])rotate([0,0,90.000000])m0(part,hole,block,casetop); // RevK:C_0402 C_0402_1005Metric (back)
translate([6.000000,41.250000,0.800000])rotate([0,0,90.000000])m0(part,hole,block,casetop); // RevK:C_0402 C_0402_1005Metric (back)
translate([32.000000,26.550000,0.800000])rotate([0,0,90.000000])m0(part,hole,block,casetop); // RevK:C_0402 C_0402_1005Metric (back)
translate([27.750000,33.250000,0.800000])rotate([0,0,90.000000])m1(part,hole,block,casetop); // RevK:R_0402_ R_0402_1005Metric (back)
}

parts_top=10;
// Parts to go on PCB (bottom)
module parts_bottom(part=false,hole=false,block=false){
}

parts_bottom=0;
module b(cx,cy,z,w,l,h){translate([cx-w/2,cy-l/2,z])cube([w,l,h]);}
module m0(part=false,hole=false,block=false,height)
{ // RevK:C_0402 C_0402_1005Metric
// 0402 Capacitor
if(part)
{
	b(0,0,0,1.0,0.5,1); // Chip
	b(0,0,0,1.5,0.65,0.2); // Pad size
}
}

module m1(part=false,hole=false,block=false,height)
{ // RevK:R_0402_ R_0402_1005Metric
// 0402 Resistor
if(part)
{
	b(0,0,0,1.5,0.65,0.2); // Pad size
	b(0,0,0,1.0,0.5,0.5); // Chip
}
}

module m2(part=false,hole=false,block=false,height)
{ // RevK:C_0603_ C_0603_1608Metric
// 0603 Capacitor
if(part)
{
	b(0,0,0,1.6,0.8,1); // Chip
	b(0,0,0,1.6,0.95,0.2); // Pad size
}
}

module m3(part=false,hole=false,block=false,height)
{ // U8
if(part)
{
	b(0,0,0,2,1.25,1);
}
if(hole)
{
	hull()
	{
		
		b(0,0,1,2,1.25,1);
        	rotate([-60,0,0]) translate([0,0,5]) b(0,0,0,5,5,1);
	}
}
if(block)
{
    translate([0,0,height-6])b(0,0,1,4,4,6);
}
}

module m4(part=false,hole=false,block=false,height,N=0)
{ // RevK:LCD2 PinSocket_1x08_P2.54mm_Vertical
translate([0,-(N-1)*2.54/2,0])
{
if(part)
{
	b(0,0,0,2.54,N*2.54,4);
}
if(hole)
{
	b(0,0,3,2.54+0.2,N*2.54+0.4,height);
	for(x=[0:1:N-1])translate([0,(x-(N-1)/2)*2.54,-3.5])cylinder(r1=0.5,r2=1,h=2.5);
}
}
}

module m5(part=false,hole=false,block=false,height)
{ // RevK:LCD2 WSLCD2
// 2" LCD
if(part)
translate([-29,17.5,8.25]) rotate([180,0,0])
{
	// Main PCB
	hull()for(x=[2.5,55.5])for(y=[2.5,32.5])translate([x,y,6])cylinder(r=2.5,h=1.5,$fn=24);
	// Display
	translate([5,0,6])cube([48,35,4]);
	// Ribbon
	translate([3.5,7.5,6])cube([2,20,3.5]);
	translate([3.5,4,6])cube([2,2,3.5]);
}
if(hole)
translate([-29,17.5,8.25]) rotate([180,0,0])
{
        translate([29+1.5,17.5,10])hull(){cube([42,32,1],center=true);translate([0,0,10])cube([52,42,1],center=true);}
        hull()for(x=[2.5,55.5])for(y=[2.5,32.5])translate([x,y,0])cylinder(r=2.5,h=6,$fn=24);
        // Pins
        for(x=[0:1:7])translate([2.4,8.61+x*2.54,0])
        {
        	translate([0,0,7.5])cylinder(d1=1.5,d2=0.254,h=1.5,$fn=24);
        	translate([0,0,-2])cylinder(d2=1.5,d1=0.254,h=1,$fn=24);
        }
        // Screws / Pillars
        for(x=[2.5,55.5])for(y=[2.5,32.5])translate([x,y,0])
        {
        	translate([0,0,-2.4])cylinder(d=4,h=1.5,$fn=24);
        	translate([0,0,-2])cylinder(d=2,h=3,$fn=24);
        }
}
}

module m6(part=false,hole=false,block=false,height)
{ // RevK:LCD2 M2x6Pillar
if(part)
{
	translate([0,0,-2.5])cylinder(d=3.5,h=2.5,$fn=24);
}
if(hole)
{
	cylinder(d=3.5,h=8.5,$fn=24);
}
}

module m7(part=false,hole=false,block=false,height)
{ // RevK:LCD2 LCDHeader
if(hole)
{
	b(0,0,0,6,20,height+1);
	b(-21,0,0,20,20,height+1);
}
}

module m8(part=false,hole=false,block=false,height)
{ // D20
// SOD-123 Diode
if(part)
{
	b(0,0,0,2.85,1.8,1.35); // part
	b(0,0,0,4.2,1.2,0.7); // pads
}
}

module m9(part=false,hole=false,block=false,height)
{ // J3
// WAGO-2060-453-998-404
N=3;
if(part)
{
	translate([-0.9,0,0])hull()
	{
		b(0,0,0,12.7,N*4-0.1,1);
		translate([0.8,0,0])b(0,0,0,11.1,N*4-0.1,4.5);
	}
	for(p=[0:N-1])translate([0,-4*(N-1)/2+p*4,2])
		rotate([90,0,-90])cylinder(d=3,h=20);
}
if(hole)
{
	for(p=[0:N-1])translate([0,-4*(N-1)/2+p*4,2])
		translate([-10,0,0])rotate([180,0,-90])cylinder(d=3,h=20);
}
}

module m10(part=false,hole=false,block=false,height)
{ // RevK:USB-C-Socket-H CSP-USC16-TR
// USB connector
rotate([-90,0,0])translate([-4.47,-3.84,0])
{
	if(part)
	{
		b(4.47,7,0,7,2,0.2);	// Pads
		translate([1.63,-0.2,1.63])
		rotate([-90,0,0])
		hull()
		{
			cylinder(d=3.26,h=7.55,$fn=24);
			translate([5.68,0,0])
			cylinder(d=3.26,h=7.55,$fn=24);
		}
		translate([0,6.2501,0])cube([8.94,1.1,1.6301]);
		translate([0,1.7,0])cube([8.94,1.6,1.6301]);
	}
	if(hole)
		translate([1.63,-20,1.63])
		rotate([-90,0,0])
	{
		// Plug
		hull()
		{
			cylinder(d=2.5,h=21,$fn=24);
			translate([5.68,0,0])
			cylinder(d=2.5,h=21,$fn=24);
		}
		hull()
		{
			cylinder(d=7,h=21,$fn=24);
			translate([5.68,0,0])
			cylinder(d=7,h=21,$fn=24);
		}
		translate([2.84,0,-100])
			cylinder(d=5,h=100,$fn=24);
	}
}
}

module m11(part=false,hole=false,block=false,height)
{ // C4
if(part)
{
	b(0,0,0,3.5,2.8,1.9);
}
}

module m12(part=false,hole=false,block=false,height)
{ // J2
// WAGO-2060-452-998-404
N=2;
if(part)
{
	translate([-0.9,0,0])hull()
	{
		b(0,0,0,12.7,N*4-0.1,1);
		translate([0.8,0,0])b(0,0,0,11.1,N*4-0.1,4.5);
	}
	for(p=[0:N-1])translate([0,-4*(N-1)/2+p*4,2])
		rotate([90,0,-90])cylinder(d=3,h=20);
}
if(hole)
{
	for(p=[0:N-1])translate([0,-4*(N-1)/2+p*4,2])
		translate([-10,0,0])rotate([180,0,-90])cylinder(d=3,h=20);
}
}

module m13(part=false,hole=false,block=false,height)
{ // RevK:SOT-23-6-MD8942 SOT-23-6
// SOT-23-6
if(part)
{
	b(0,0,0,1.726,3.026,1.2); // Part
	b(0,0,0,3.6,2.5,0.5); // Pins
}
}

module m14(part=false,hole=false,block=false,height)
{ // U5
if(part)
{
	b(0,0,0,2.5,2,0.65);
}
}

module m15(part=false,hole=false,block=false,height)
{ // RevK:L_4x4_ TYA4020
// 4x4 Inductor
if(part)
{
	b(0,0,0,4,4,3);
}
}

module m16(part=false,hole=false,block=false,height)
{ // D4
// 1x1mm LED
if(part)
{
        b(0,0,0,1.2,1.2,.8);
}
if(hole)
{
	hull()
	{
                b(0,0,.8,1.2,1.2,1);
        	rotate([-60,0,0]) translate([0,0,5]) b(0,0,0,5,5,1);
	}
}
if(block)
{
    b(0,0,.8,4,4,height);
}
}

module m17(part=false,hole=false,block=false,height)
{ // U1
// ESP32-S3-MINI-1
translate([-15.4/2,-15.45/2,0])
{
	if(part)
	{
		cube([15.4,20.5,0.8]);
		translate([0.7,0.5,0])cube([14,13.55,2.4]);
	}
	if(hole)
	{
		cube([15.4,20.5,0.8]);
	}
}
}

module m18(part=false,hole=false,block=false,height)
{ // U4
if(part)
{
	b(0,0,0,3,3,1.1);
	b(0,0,0,4.9,2.5,0.6);
}
if(hole)
{
	hull()
	{
                b(0,0,-2,6,6,4);
        	rotate([-60,0,-90]) translate([0,0,8]) b(0,0,0,8,5,1);
	}
}
if(block)
{
    translate([0,0,height-6])b(0,0,-2,7,8,6);
}
}

// Generate PCB casework

height=casebottom+pcbthickness+casetop;
$fn=48;

module pyramid()
{ // A pyramid
 polyhedron(points=[[0,0,0],[-height,-height,height],[-height,height,height],[height,height,height],[height,-height,height]],faces=[[0,1,2],[0,2,3],[0,3,4],[0,4,1],[4,3,2,1]]);
}


module pcb_hulled(h=pcbthickness,r=0)
{ // PCB shape for case
	if(useredge)outline(h,r);
	else hull()outline(h,r);
}

module solid_case(d=0)
{ // The case wall
	hull()
        {
                translate([0,0,-casebottom])pcb_hulled(height,casewall-edge);
                translate([0,0,edge-casebottom])pcb_hulled(height-edge*2,casewall);
        }
}

module preview()
{
	pcb();
	color("#0f0")parts_top(part=true);
	color("#0f0")parts_bottom(part=true);
	color("#f00")parts_top(hole=true);
	color("#f00")parts_bottom(hole=true);
	color("#00f8")parts_top(block=true);
	color("#00f8")parts_bottom(block=true);
}

module top_half(step=false)
{
	difference()
	{
		translate([-casebottom-100,-casewall-100,pcbthickness-lip/2+0.01]) cube([pcbwidth+casewall*2+200,pcblength+casewall*2+200,height]);
		if(step)translate([0,0,pcbthickness-lip/2-0.01])pcb_hulled(lip,casewall/2+fit);
	}
}

module bottom_half(step=false)
{
	translate([-casebottom-100,-casewall-100,pcbthickness+lip/2-height-0.01]) cube([pcbwidth+casewall*2+200,pcblength+casewall*2+200,height]);
	if(step)translate([0,0,pcbthickness-lip/2])pcb_hulled(lip,casewall/2-fit);
}

module case_wall()
{
	difference()
	{
		solid_case();
		translate([0,0,-height])pcb_hulled(height*2);
	}
}

module top_side_hole()
{
	intersection()
	{
		parts_top(hole=true);
		case_wall();
	}
}

module bottom_side_hole()
{
	intersection()
	{
		parts_bottom(hole=true);
		case_wall();
	}
}

module parts_space()
{
	minkowski()
	{
		union()
		{
			parts_top(part=true,hole=true);
			parts_bottom(part=true,hole=true);
		}
		sphere(r=margin,$fn=6);
	}
}

module top_cut()
{
	difference()
	{
		top_half(true);
		if(parts_top)difference()
		{
			minkowski()
			{ // Penetrating side holes
				top_side_hole();
				rotate([180,0,0])
				pyramid();
			}
			minkowski()
			{
				top_side_hole();
				rotate([0,0,45])cylinder(r=margin,h=height,$fn=4);
			}
		}
	}
	if(parts_bottom)difference()
	{
		minkowski()
		{ // Penetrating side holes
			bottom_side_hole();
			pyramid();
		}
			minkowski()
			{
				bottom_side_hole();
				rotate([0,0,45])translate([0,0,-height])cylinder(r=margin,h=height,$fn=4);
			}
	}
}

module bottom_cut()
{
	difference()
	{
		 translate([-casebottom-50,-casewall-50,-height]) cube([pcbwidth+casewall*2+100,pcblength+casewall*2+100,height*2]);
		 top_cut();
	}
}

module top_body()
{
	difference()
	{
		intersection()
		{
			solid_case();
			pcb_hulled(height);
			top_half();
		}
		if(parts_top)minkowski()
		{
			if(nohull)parts_top(part=true);
			else hull()parts_top(part=true);
			translate([0,0,margin-height])cylinder(r=margin,h=height,$fn=8);
		}
	}
	intersection()
	{
		solid_case();
		parts_top(block=true);
	}
}

module top_edge()
{
	intersection()
	{
		case_wall();
		top_cut();
	}
}

module top()
{
	translate([casewall,casewall+pcblength,pcbthickness+casetop])rotate([180,0,0])difference()
	{
		union()
		{
			top_body();
			top_edge();
		}
		parts_space();
		translate([0,0,pcbthickness-height])pcb(height,r=margin);
	}
}

module bottom_body()
{
	difference()
	{
		intersection()
		{
			solid_case();
			translate([0,0,-height])pcb_hulled(height);
			bottom_half();
		}
		if(parts_bottom)minkowski()
		{
			if(nohull)parts_bottom(part=true);
			else hull()parts_bottom(part=true);
			translate([0,0,-margin])cylinder(r=margin,h=height,$fn=8);
		}
	}
	intersection()
	{
		solid_case();
		parts_bottom(block=true);
	}
}

module bottom_edge()
{
	intersection()
	{
		case_wall();
		bottom_cut();
	}
}

module bottom()
{
	translate([casewall,casewall,casebottom])difference()
	{
		union()
		{
        		bottom_body();
        		bottom_edge();
		}
		parts_space();
		pcb(height,r=margin);
	}
}
bottom(); translate([spacing,0,0])top();
