revk/ESP32-EnvMon/(list of files, cad)

Other CAD files:
PCB/Env2-BPCO2DS.stl
PCB/Env2-BPDS.stl
PCB/Env2-Cover.stl
PCB/Env2-Cover2CO2.stl
PCB/Env2-BP24DS.scad
PCB/Env2-BPCO2DS.scad
PCB/Env2-BPDS.scad
PCB/Env2-CoverCO2.scad
PCB/lcd24.scad
PCB/Env2/EnvMonBlind.scad
PCB/Env2/EnvMonCO2.scad
PCB/EnvHT/EnvHT.scad
PCB/EnvMon/EnvMon-flush-nooled.scad
PCB/EnvMon/EnvMon-flush.scad
PCB/EnvMon/EnvMon-noco2.scad
PCB/EnvMon/EnvMon-nooled.scad
PCB/EnvMon/EnvMon.scad
PCB/USBC/USBC.scad
PCB/blankplate.scad
