revk/ESP32-EnvMon/PCB/Env2/EnvMon.kicad_pcb

## KiCad design PCB/Env2/EnvMon.kicad_pcb (2025-05-02)

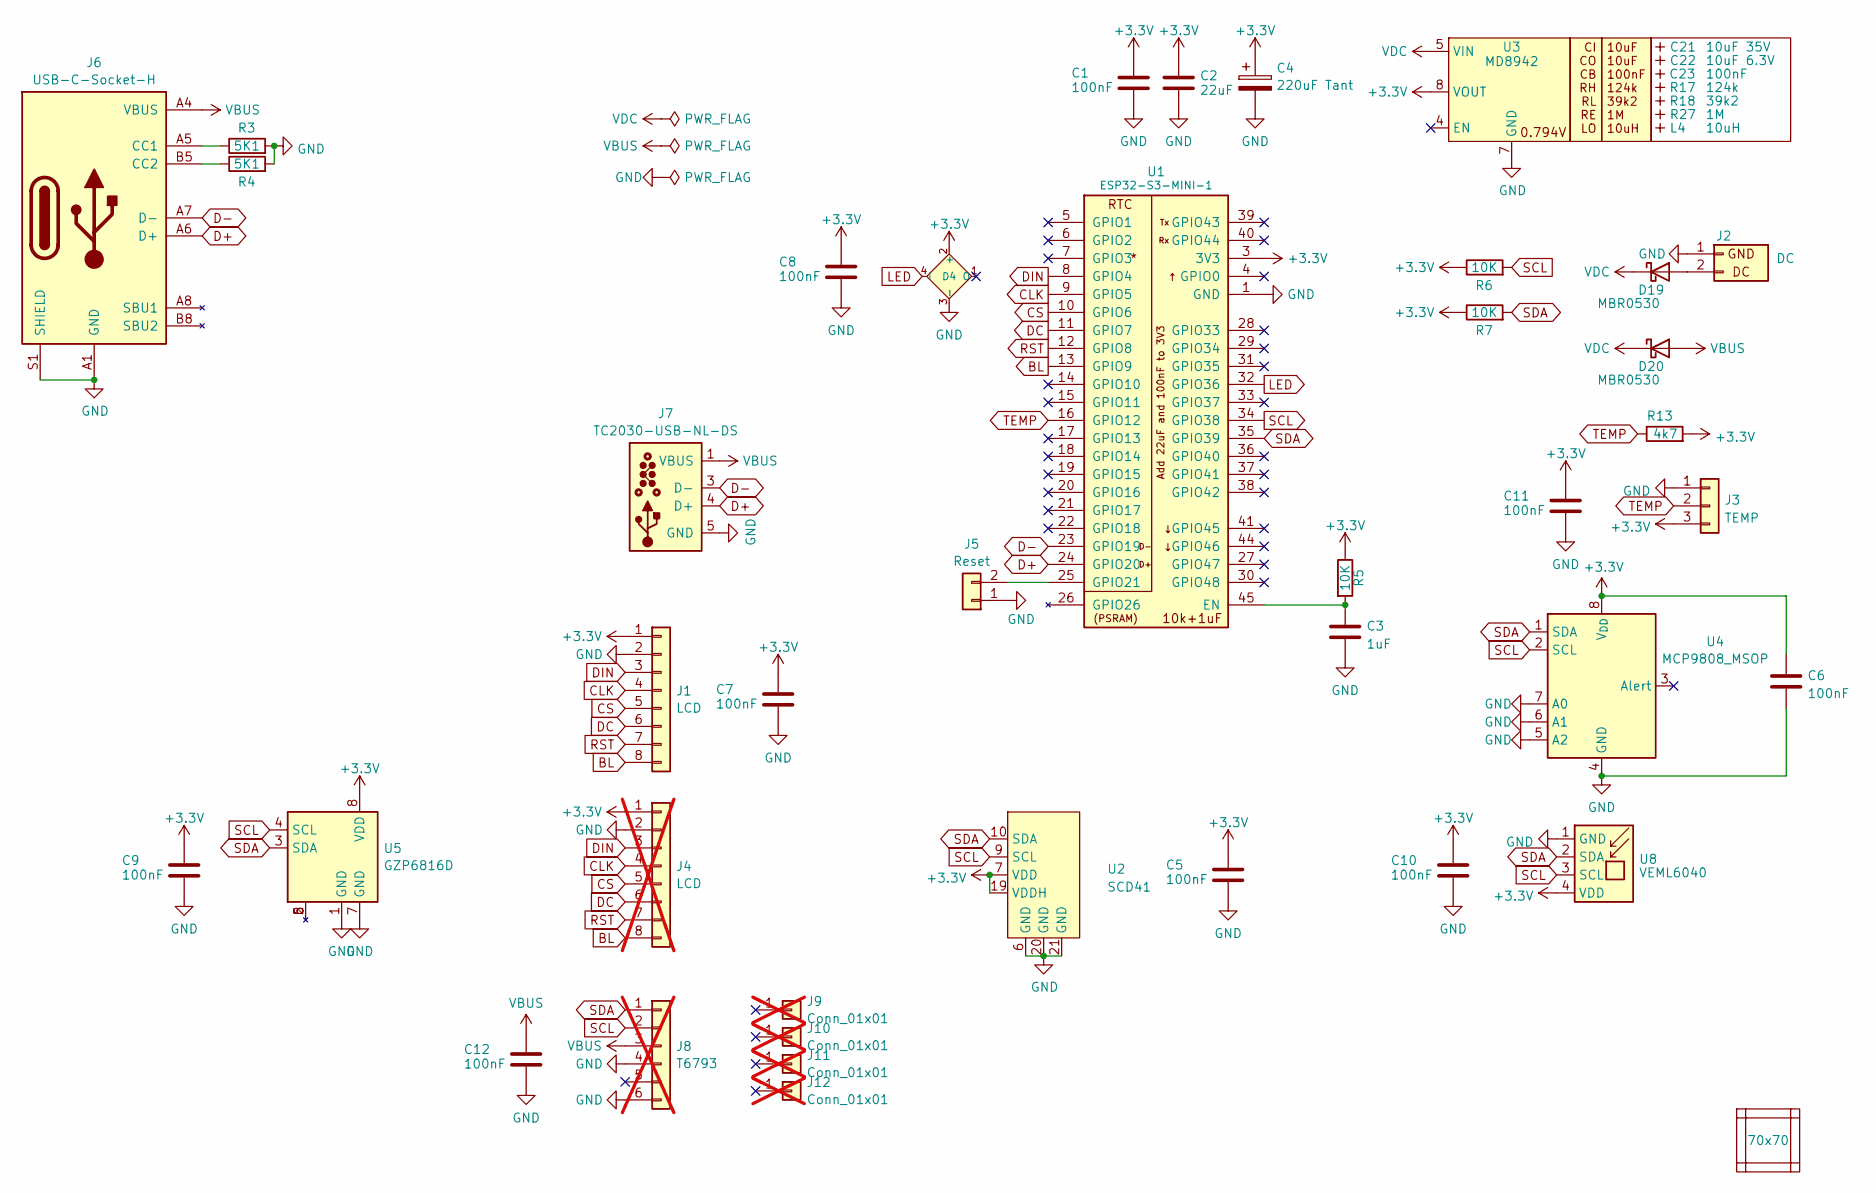
[picture p39: schematic EnvMon.kicad_sch, 2" LCD]

Parts:
C1, C5, C6, C7, C8, C9, C10, C11, C12: 100nF; C_0402
C2: 22uF; C_0402
C3: 1uF; C_0402
C4: 220uF Tant; CP_EIA-3528-21_Kemet-B; MPN C122649
C21: 10uF 35V; C_0603_; MPN C194427
C22: 10uF 6.3V; C_0603_; MPN C1691
C23: 100nF; C_0603_
D4: XL-1010RGBC-WS2812B; SMD1010-Side2; MPN C5349953
D19, D20: MBR0530; D_SOD-123; MPN C5204746
J1: LCD; LCD2; MPN C42380985
J2: DC; WAGO-2060-452-998-404; MPN C2765055
J3: TEMP; WAGO-2060-453-998-404; MPN C2765056
J4: LCD; PinHeader_1x08_P2.54mm_Vertical; MPN C42380985; not fitted
J5: Reset; AA-Pad
J6: USB-C-Socket-H; MPN C709357
J7: TC2030-USB-NL-DS; Tag-Connect_TC2030-IDC-NL_2x03_P1.27mm_Vertical
J8: T6793; PinHeader_1x06_P2.54mm_Vertical; not fitted
J9, J10, J11, J12: Conn_01x01; PinHeader_1x01_P2.54mm_Vertical; not fitted
L4: 10uH; L_4x4_; MPN C167879
PCB1: 70x70; PCB7070
R3, R4: 5K1; R_0402
R5, R6, R7: 10K; R_0402
R13: 4k7; R_0402
R17: 124k; R_0402_
R18: 39k2; R_0402_
R27: 1M; R_0402_
U1: ESP32-S3-MINI-1; MPN C3013941
U2: SCD41; MPN C3659294
U3: MD8942; SOT-23-6-MD8942; MPN C2684786
U4: MCP9808_MSOP; MSOP-8_3x3mm_P0.65mm-SIde; MPN C94847
U5: GZP6816D; Bosch_LGA-8_2x2.5mm_P0.65mm_ClockwisePinNumbering; MPN C3038127
U8: VEML6040; VEML6040-Side; MPN C78465
V1, V2, V3, V4: VCUT70

Connections:
+3.3V: C1.1, C2.1, C4.1, C5.1, C6.1, C7.1, C8.1, C9.1, C10.1, C11.1, D4.2 (+), J1.1, J3.3, J4.1, R5.1, R6.1, R7.1, R13.2, U1.3 (3V3), U2.7 (VDD), U2.19 (VDDH), U3.8 (VOUT), U4.8 (V_{DD}), U5.8 (VDD), U8.4 (VDD)
BL: J1.8, J4.8, U1.13 (GPIO9)
CLK: J1.4, J4.4, U1.9 (GPIO5)
CS: J1.5, J4.5, U1.10 (GPIO6)
D+: J6.A6 (D+), J6.B6 (D+), J7.4 (D+), U1.24 (GPIO20)
D-: J6.A7 (D-), J6.B7 (D-), J7.2 (NC), J7.3 (D-), J7.6 (NC), U1.23 (GPIO19)
DC: J1.6, J4.6, U1.11 (GPIO7)
DIN: J1.3, J4.3, U1.8 (GPIO4)
GND: C1.2, C2.2, C3.2, C4.2, C5.2, C6.2, C7.2, C8.2, C9.2, C10.2, C11.2, C12.2, D4.3 (-), J1.2, J2.1 (GND), J3.1, J4.2, J5.1, J6.A1 (GND), J6.A12 (GND), J6.B1 (GND), J6.B12 (GND), J6.S1 (SHIELD), J7.5 (GND), J8.4, J8.6, R3.2, R4.2, U1.1 (GND), U1.2 (GND), U1.42 (GND), U1.43 (GND), U1.46 (GND), U1.47 (GND), U1.48 (GND), U1.49 (GND), U1.50 (GND), U1.51 (GND), U1.52 (GND), U1.53 (GND), U1.54 (GND), U1.55 (GND), U1.56 (GND), U1.57 (GND), U1.58 (GND), U1.59 (GND), U1.60 (GND), U1.61 (GND), U1.62 (GND), U1.63 (GND), U1.64 (GND), U1.65 (GND), U2.6 (GND), U2.20 (GND), U2.21 (GND), U3.2 (GND), U3.7 (GND), U4.4 (GND), U4.5 (A2), U4.6 (A1), U4.7 (A0), U5.1 (GND), U5.7 (GND), U8.1 (GND)
LED: D4.4 (I), U1.32 (GPIO36)
unnamed: D19.2 (A), J2.2 (DC)
unnamed: J5.2, U1.25 (GPIO21)
unnamed: J6.A5 (CC1), R3.1
unnamed: J6.B5 (CC2), R4.1
unnamed: C3.1, R5.2, U1.45 (EN)
RST: J1.7, J4.7, U1.12 (GPIO8)
SCL: J8.2, R6.2, U1.34 (GPIO38), U2.9 (SCL), U4.2 (SCL), U5.4 (SCL), U8.3 (SCL)
SDA: J8.1, R7.2, U1.35 (GPIO39), U2.10 (SDA), U4.1 (SDA), U5.3 (SDA), U8.2 (SDA)
TEMP: J3.2, R13.1, U1.16 (GPIO12)
VBUS: C12.1, D20.2 (A), J6.A4 (VBUS), J6.A9 (VBUS), J6.B4 (VBUS), J6.B9 (VBUS), J7.1 (VBUS), J8.3
VDC: D19.1 (K), D20.1 (K), U3.5 (VIN)

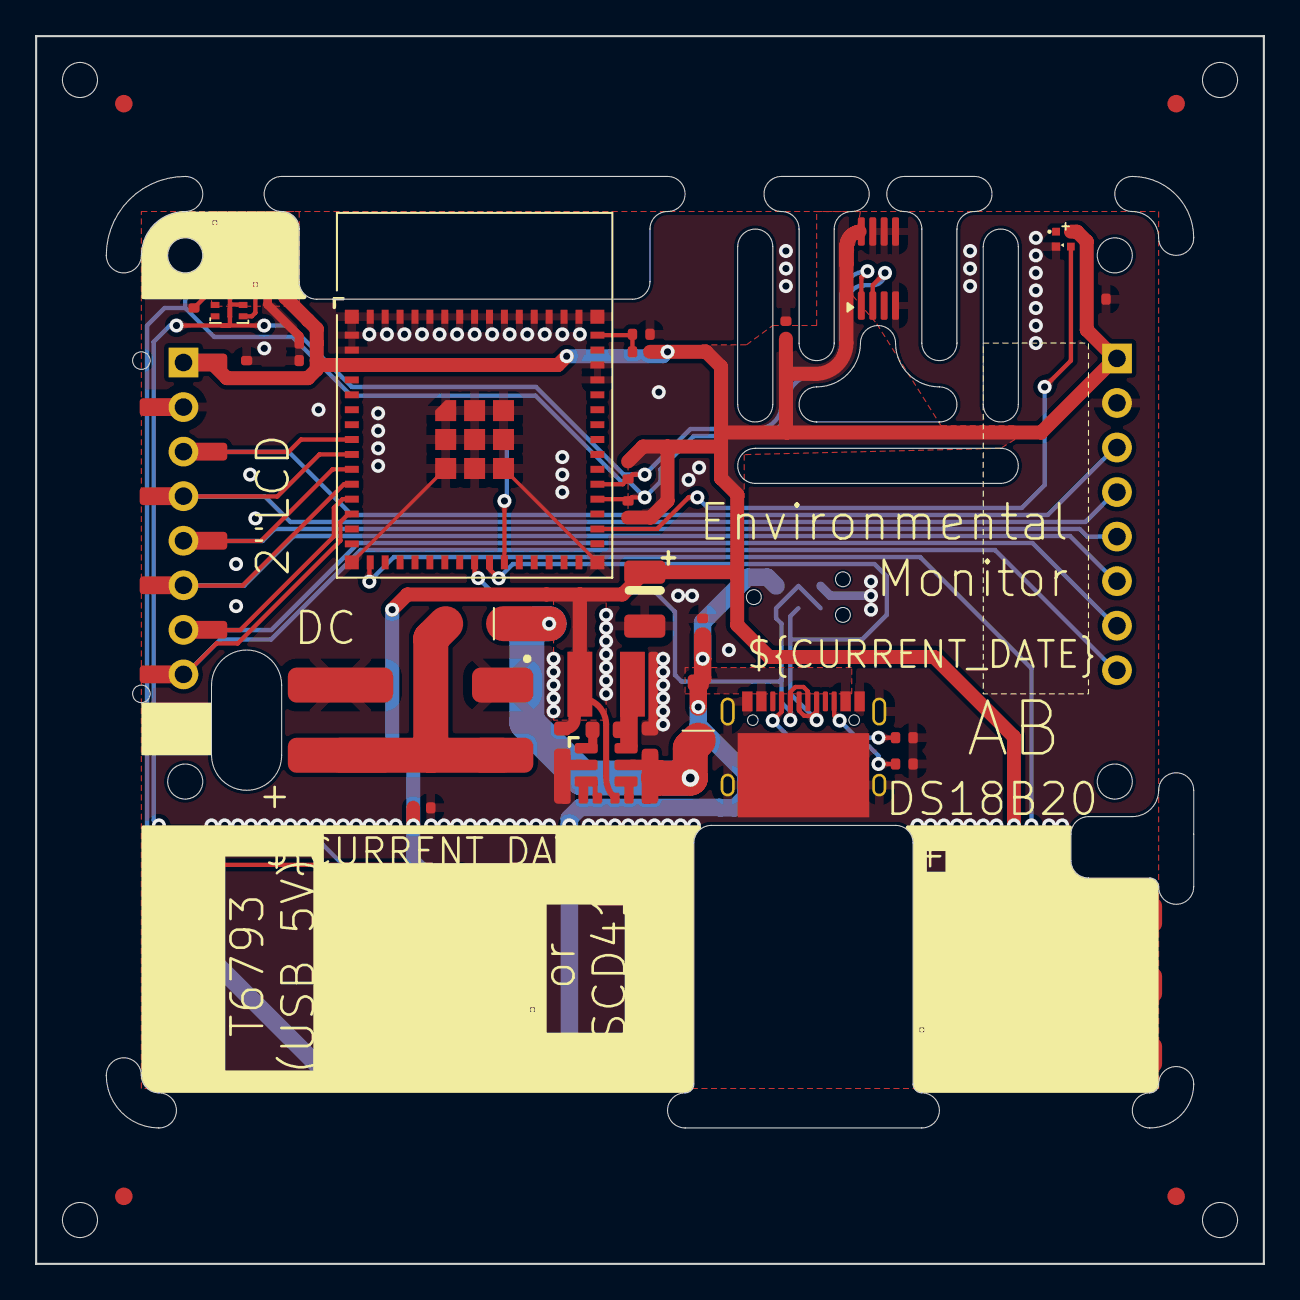
[picture p40: board PCB/Env2/EnvMon.kicad_pcb from above]

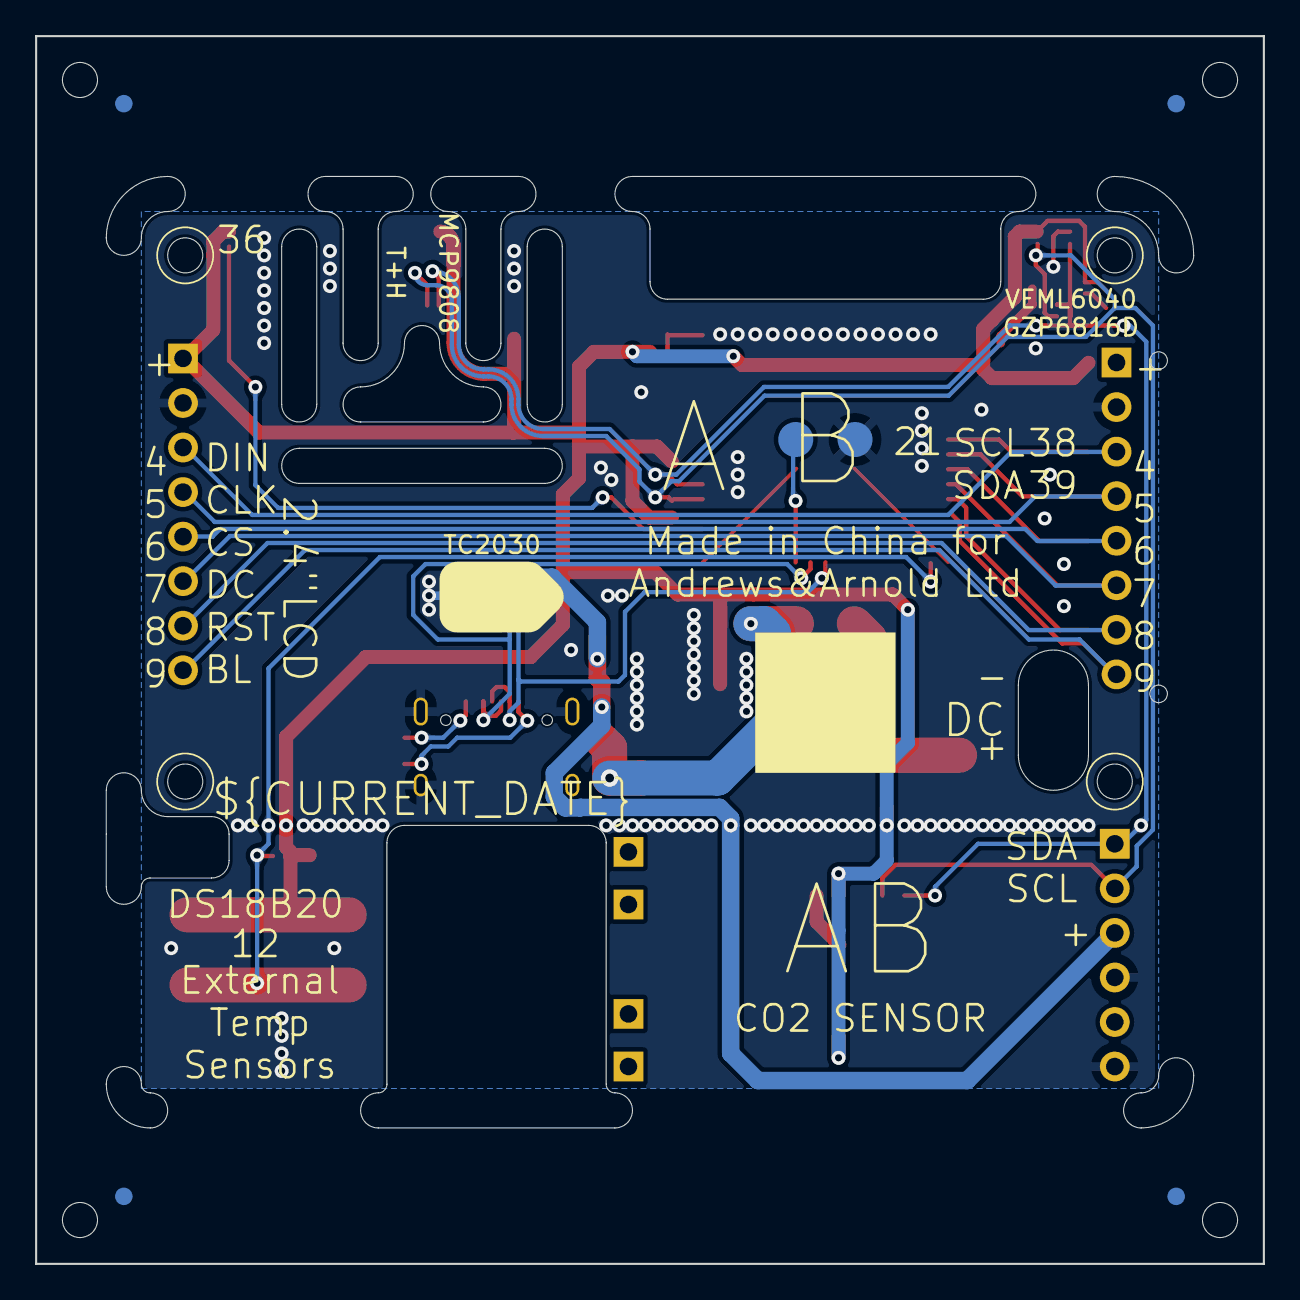
[picture p41: board PCB/Env2/EnvMon.kicad_pcb from below]

Board: 2 copper layers, 70.0 x 70.0 mm, 51 parts (3 on the bottom side), 21 nets.
