revk/ESP32-EnvMon/PCB/EnvHT/EnvHT.kicad_pcb

## KiCad design PCB/EnvHT/EnvHT.kicad_pcb (2025-01-23)

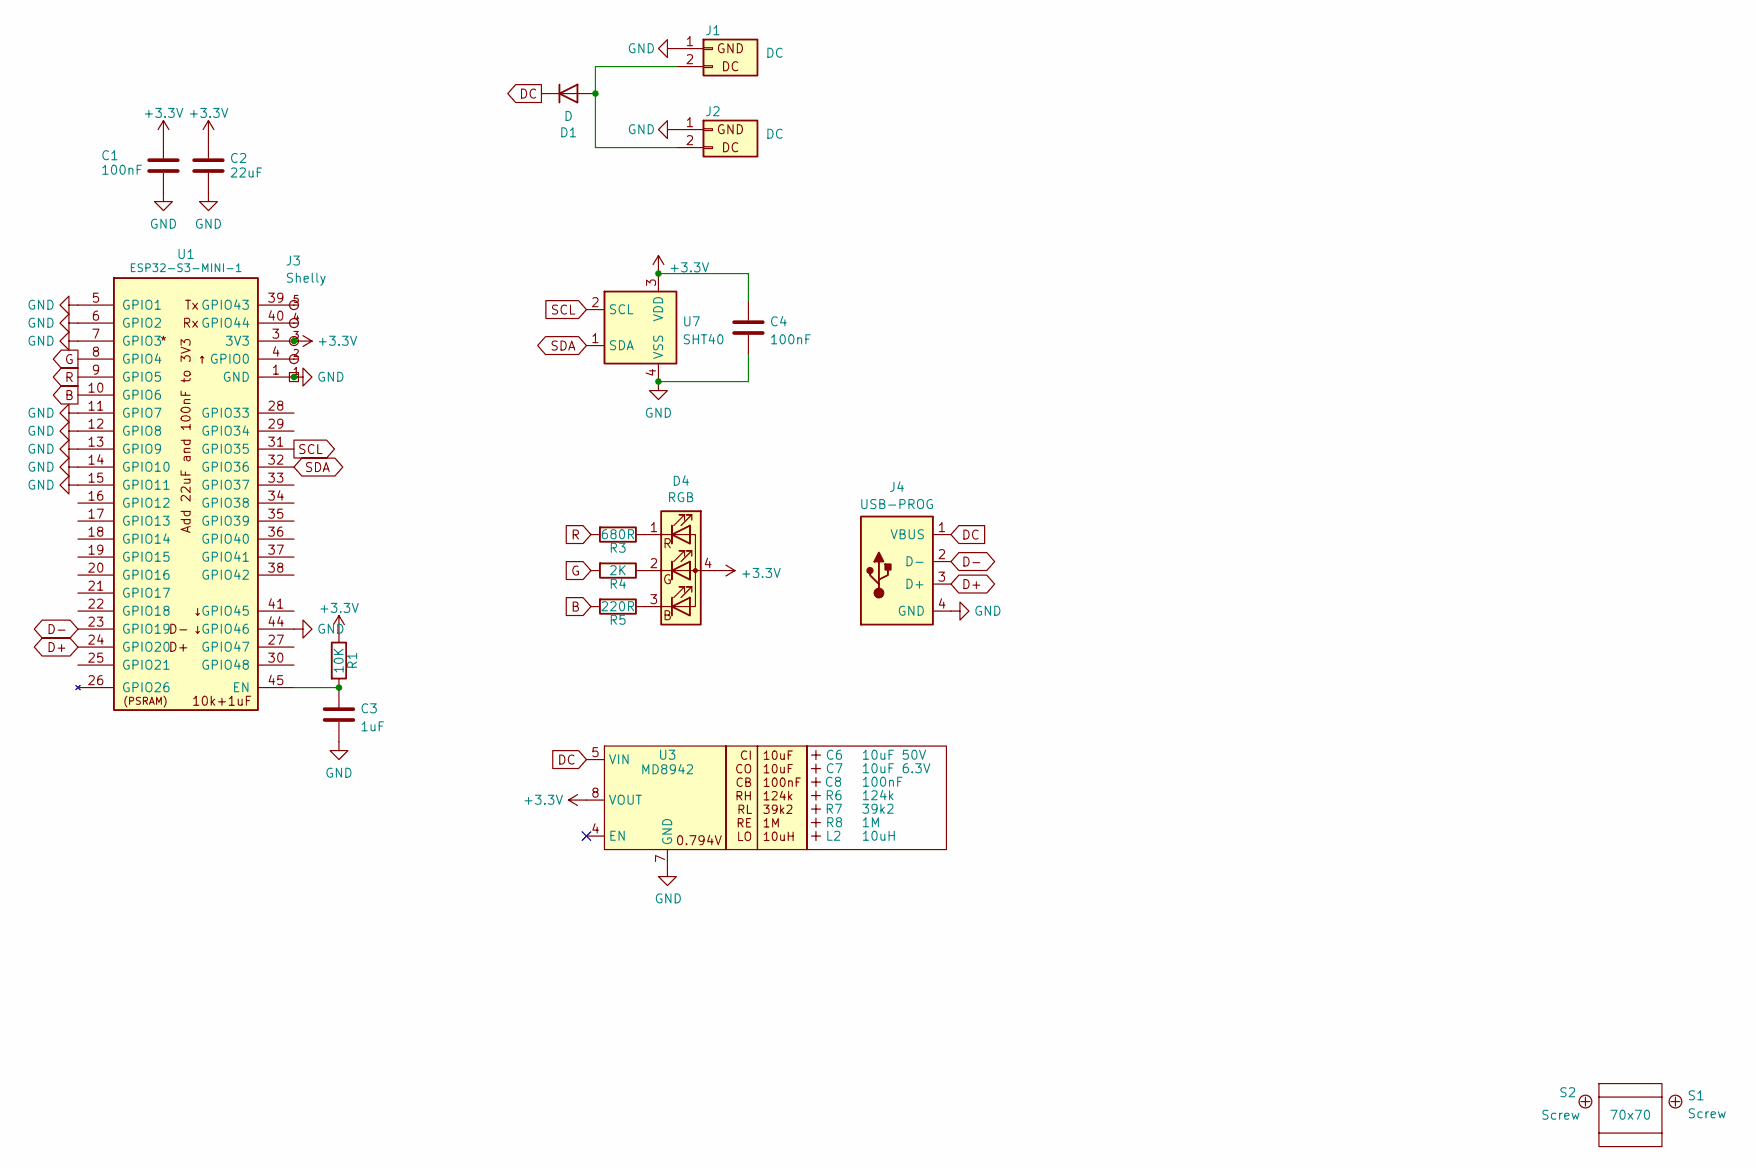
[picture p42: schematic EnvHT.kicad_sch, Simple Humidity / Temp sensor 12V]

Parts:
C1, C4: 100nF; C_0402
C2: 22uF; C_0603
C3: 1uF; C_0402
C6: 10uF 50V; C_0603_; MPN C1591
C7: 10uF 6.3V; C_0603_; MPN C1691
C8: 100nF; C_0603_
D1: D; D_SOD-123; MPN C1884542
D4: RGB; LED-RGB-1.6x1.6; Part No APTF1616LSEEZGKQBKC
J1, J2: DC; PTSM-HH1-2-RA
J3: Shelly
J4: USB-PROG
L2: 10uH; L_4x4_
PCB1: 70x70; PCB7070
R1: 10K; R_0402
R3: 680R; R_0402
R4: 2K; R_0402
R5: 220R; R_0402
R6: 124k; R_0402_
R7: 39k2; R_0402_
R8: 1M; R_0402_
S1, S2: Screw
U1: ESP32-S3-MINI-1; MPN C3013941
U3: MD8942; SOT-23-6-MD8942; MPN C2684786
U7: SHT40; Sensirion_DFN-4_1.5x1.5mm_P0.5mm_SHT4x; MPN C2909890
V2, V3: VCUT70

Connections:
+3.3V: C1.1, C2.1, C4.1, D4.4 (A), J3.3 (3V3), R1.1, U1.3 (3V3), U3.8 (VOUT), U7.3 (VDD)
B: R5.2, U1.10 (GPIO6)
D+: J4.3 (D+), U1.24 (GPIO20)
D-: J4.2 (D-), U1.23 (GPIO19)
DC: D1.1 (K), J4.1 (VBUS), U3.5 (VIN)
G: R4.2, U1.8 (GPIO4)
GND: C1.2, C2.2, C3.2, C4.2, J1.1 (GND), J2.1 (GND), J3.1 (GND), J4.4 (GND), U1.1 (GND), U1.2 (GND), U1.5 (GPIO1), U1.6 (GPIO2), U1.7 (GPIO3), U1.11 (GPIO7), U1.12 (GPIO8), U1.13 (GPIO9), U1.14 (GPIO10), U1.15 (GPIO11), U1.42 (GND), U1.43 (GND), U1.44 (GPIO46), U1.46 (GND), U1.47 (GND), U1.48 (GND), U1.49 (GND), U1.50 (GND), U1.51 (GND), U1.52 (GND), U1.53 (GND), U1.54 (GND), U1.55 (GND), U1.56 (GND), U1.57 (GND), U1.58 (GND), U1.59 (GND), U1.60 (GND), U1.61 (GND), U1.62 (GND), U1.63 (GND), U1.64 (GND), U1.65 (GND), U3.2 (GND), U3.7 (GND), U7.4 (VSS)
unnamed: D1.2 (A), J1.2 (DC), J2.2 (DC)
unnamed: D4.3 (BK), R5.1
unnamed: D4.2 (GK), R4.1
unnamed: D4.1 (RK), R3.1
unnamed: J3.2 (0), U1.4 (GPIO0)
unnamed: J3.4 (Rx), U1.40 (GPIO44)
unnamed: J3.5 (Tx), U1.39 (GPIO43)
unnamed: C3.1, R1.2, U1.45 (EN)
R: R3.2, U1.9 (GPIO5)
SCL: U1.31 (GPIO35), U7.2 (SCL)
SDA: U1.32 (GPIO36), U7.1 (SDA)

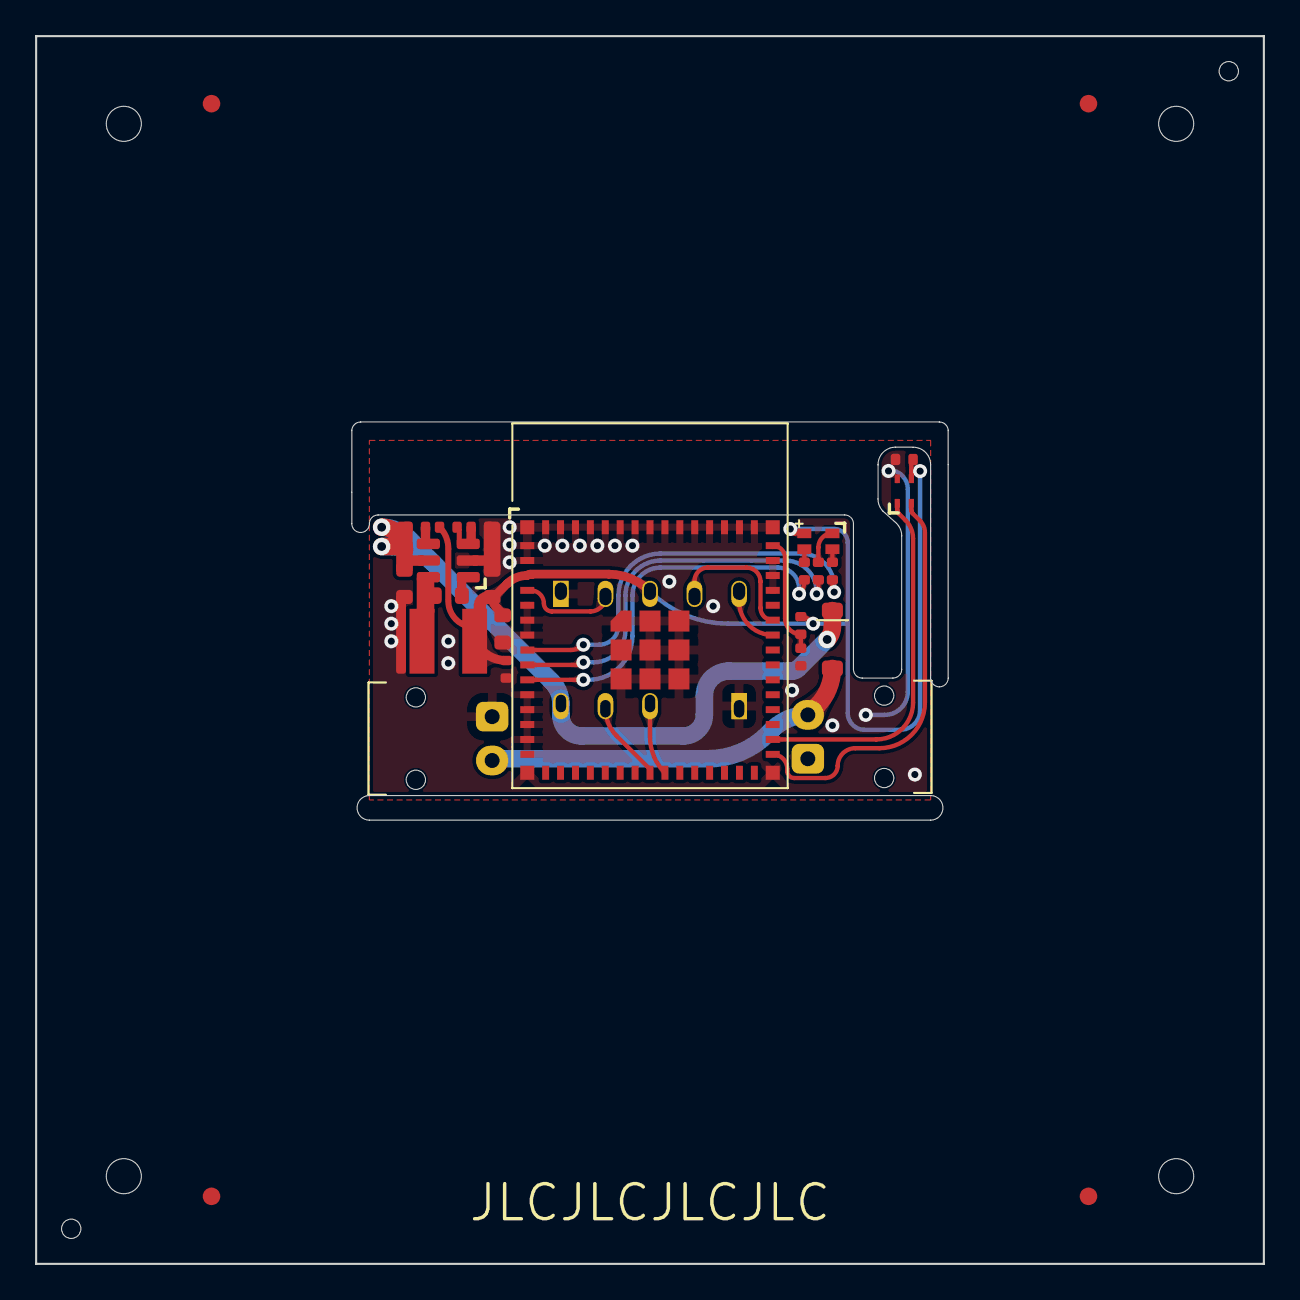
[picture p43: board EnvHT.kicad_pcb from above]

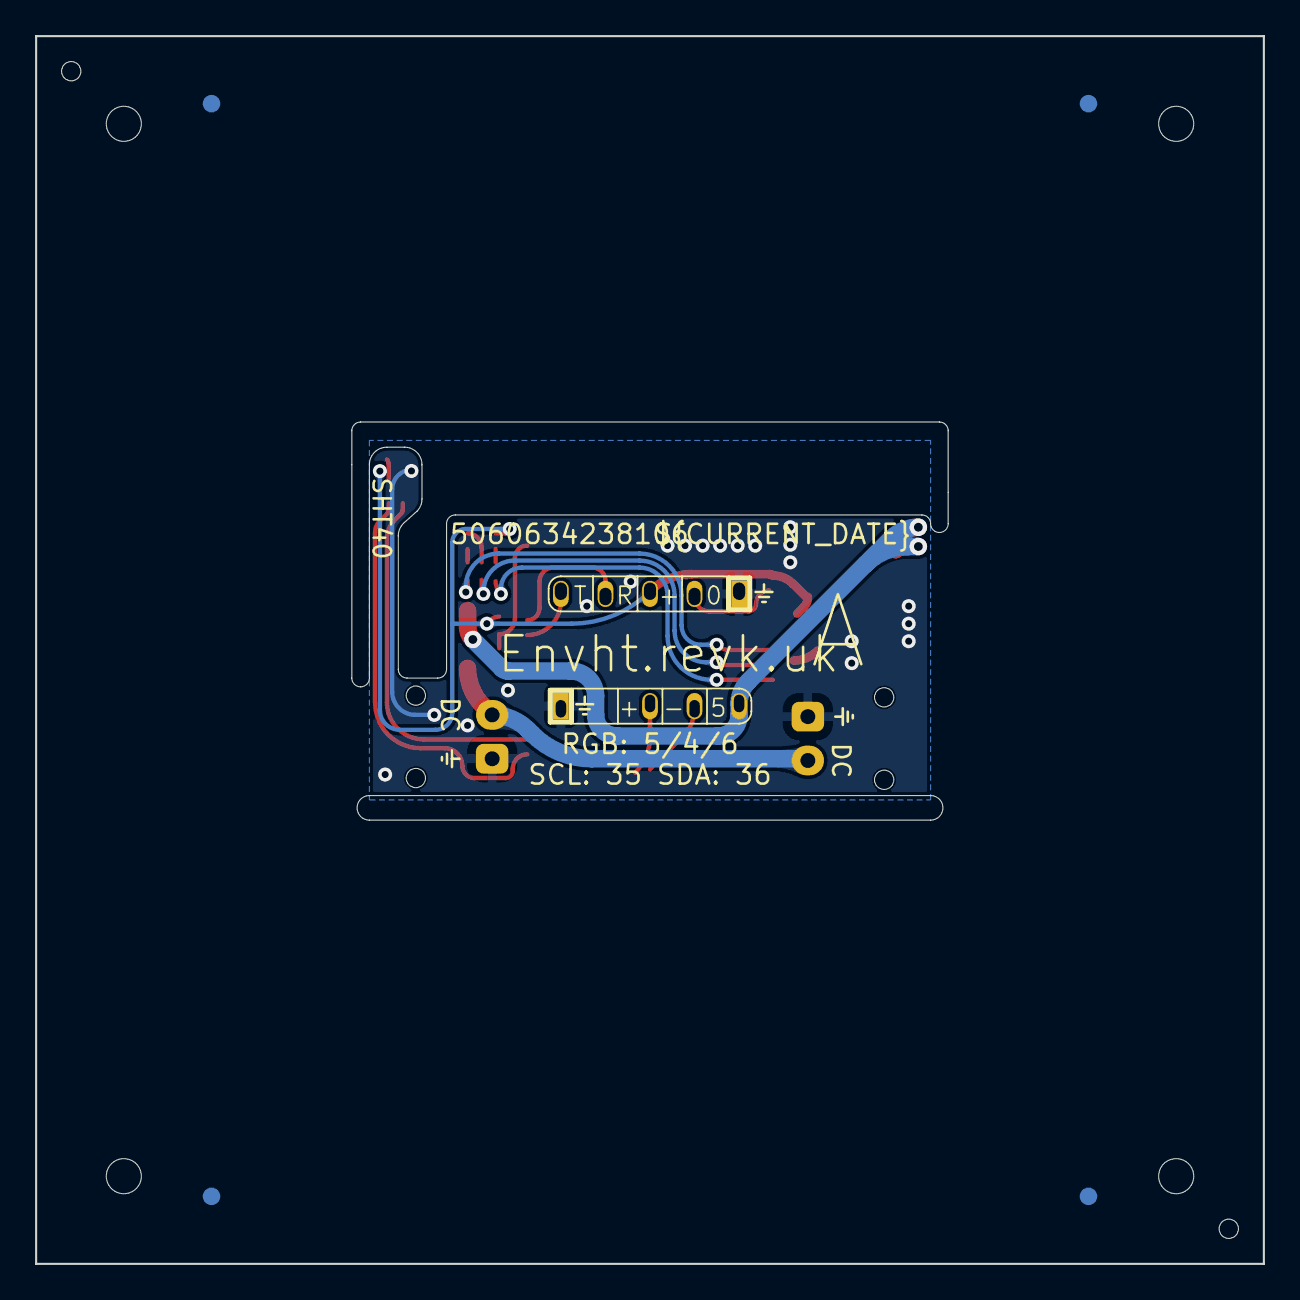
[picture p44: board EnvHT.kicad_pcb from below]

Board: 2 copper layers, 70.0 x 70.0 mm, 29 parts (2 on the bottom side), 18 nets.
