revk/ESP32-EnvMon/PCB/EnvMon/EnvMon.kicad_pcb

## KiCad design PCB/EnvMon/EnvMon.kicad_pcb (2025-01-23)

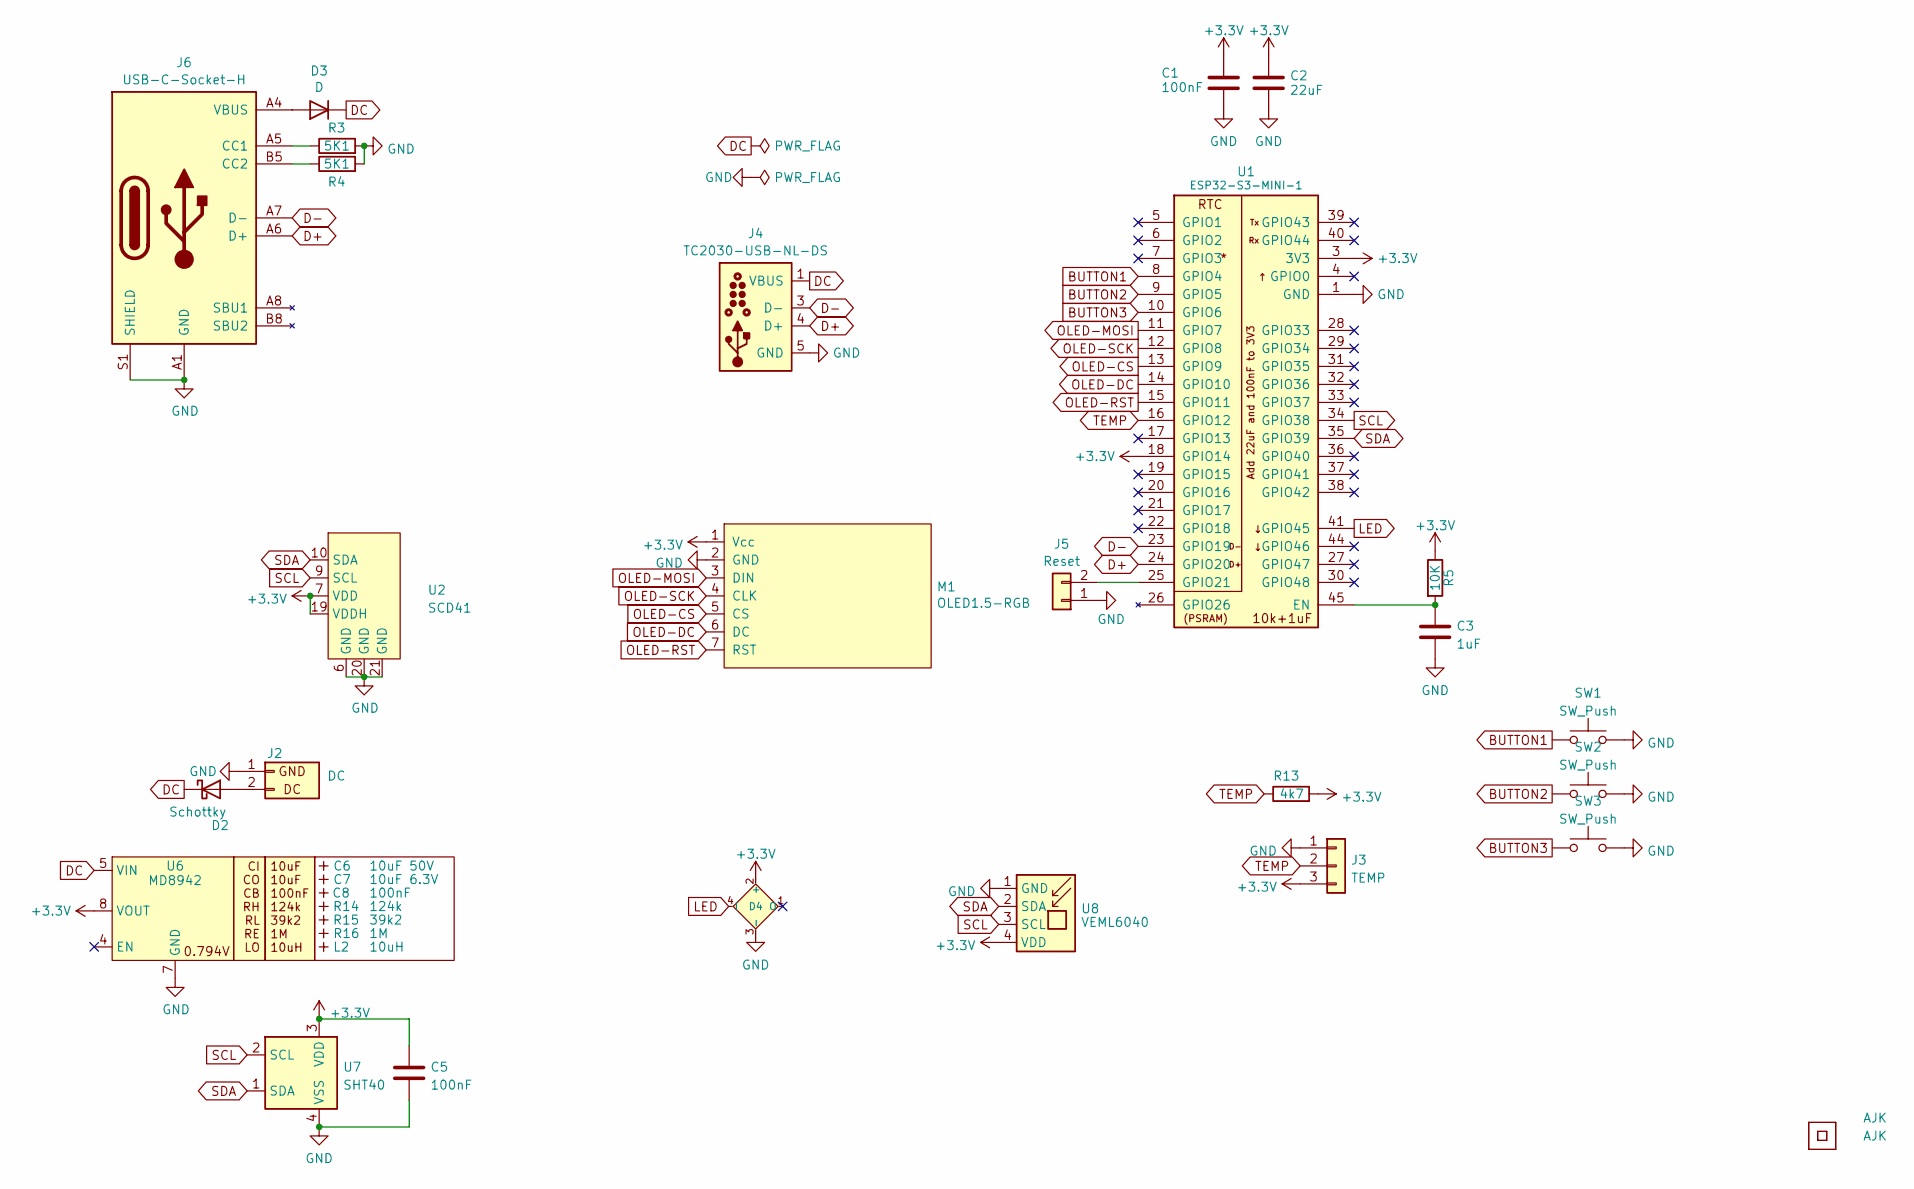
[picture p45: schematic EnvMon.kicad_sch, 1.5" OLED Module driver with GPIO]

Parts:
C1, C5: 100nF; C_0402
C2: 22uF; C_0402
C3: 1uF; C_0402
C6: 10uF 50V; C_0603_; MPN C1591
C7: 10uF 6.3V; C_0603_; MPN C1691
C8: 100nF; C_0603_
D2: Schottky; D_1206; MPN C143805
D3: D; D_SOD-123; MPN C1884542
D4: XL-1010RGBC-WS2812B; SMD1010; MPN C5349953
J2: DC; WAGO-2060-452-998-404
J3: TEMP; WAGO-2060-453-998-404
J4: TC2030-USB-NL-DS; Tag-Connect_TC2030-IDC-NL_2x03_P1.27mm_Vertical
J5: Reset; AA-Pad
J6: USB-C-Socket-H; MPN C709357
L2: 10uH; L_4x4_
Logo1, Logo2: AJK
M1: OLED1.5-RGB
R3, R4: 5K1; R_0402
R5: 10K; R_0402
R13: 4k7; R_0402
R14: 124k; R_0402_
R15: 39k2; R_0402_
R16: 1M; R_0402_
SW1, SW2, SW3: SW_Push; SW_PUSH_6mm_H13mm
U1: ESP32-S3-MINI-1; MPN C3013941
U2: SCD41
U5: QR; QR-ENVMON
U6: MD8942; SOT-23-6-MD8942; MPN C2684786
U7: SHT40; Sensirion_DFN-4_1.5x1.5mm_P0.5mm_SHT4x; MPN C2909890
U8: VEML6040; MPN C78465

Connections:
+3.3V: C1.1, C2.1, C5.1, D4.2 (+), J3.3, M1.1 (Vcc), R5.1, R13.2, U1.3 (3V3), U1.18 (GPIO14), U2.7 (VDD), U2.19 (VDDH), U6.8 (VOUT), U7.3 (VDD), U8.4 (VDD)
BUTTON1: SW1.1, U1.8 (GPIO4)
BUTTON2: SW2.1, U1.9 (GPIO5)
BUTTON3: SW3.1, U1.10 (GPIO6)
D+: J4.4 (D+), J6.A6 (D+), J6.B6 (D+), U1.24 (GPIO20)
D-: J4.3 (D-), J6.A7 (D-), J6.B7 (D-), U1.23 (GPIO19)
DC: D2.1 (K), D3.1 (K), J4.1 (VBUS), J4.2 (VBUS), U6.5 (VIN)
GND: C1.2, C2.2, C3.2, C5.2, D4.3 (-), J2.1 (GND), J3.1, J4.5 (GND), J4.6 (GND), J5.1, J6.A1 (GND), J6.A12 (GND), J6.B1 (GND), J6.B12 (GND), J6.S1 (SHIELD), M1.2 (GND), R3.2, R4.2, SW1.2, SW2.2, SW3.2, U1.1 (GND), U1.2 (GND), U1.42 (GND), U1.43 (GND), U1.46 (GND), U1.47 (GND), U1.48 (GND), U1.49 (GND), U1.50 (GND), U1.51 (GND), U1.52 (GND), U1.53 (GND), U1.54 (GND), U1.55 (GND), U1.56 (GND), U1.57 (GND), U1.58 (GND), U1.59 (GND), U1.60 (GND), U1.61 (GND), U1.62 (GND), U1.63 (GND), U1.64 (GND), U1.65 (GND), U2.6 (GND), U2.20 (GND), U2.21 (GND), U6.2 (GND), U6.7 (GND), U7.4 (VSS), U8.1 (GND)
LED: D4.4 (I), U1.41 (GPIO45)
unnamed: D2.2 (A), J2.2 (DC)
unnamed: D3.2 (A), J6.A4 (VBUS), J6.A9 (VBUS), J6.B4 (VBUS), J6.B9 (VBUS)
unnamed: J5.2, U1.25 (GPIO21)
unnamed: J6.A5 (CC1), R3.1
unnamed: J6.B5 (CC2), R4.1
unnamed: C3.1, R5.2, U1.45 (EN)
OLED-CS: M1.5 (CS), U1.13 (GPIO9)
OLED-DC: M1.6 (DC), U1.14 (GPIO10)
OLED-MOSI: M1.3 (DIN), U1.11 (GPIO7)
OLED-RST: M1.7 (RST), U1.15 (GPIO11)
OLED-SCK: M1.4 (CLK), U1.12 (GPIO8)
SCL: U1.34 (GPIO38), U2.9 (SCL), U7.2 (SCL), U8.3 (SCL)
SDA: U1.35 (GPIO39), U2.10 (SDA), U7.1 (SDA), U8.2 (SDA)
TEMP: J3.2, R13.1, U1.16 (GPIO12)

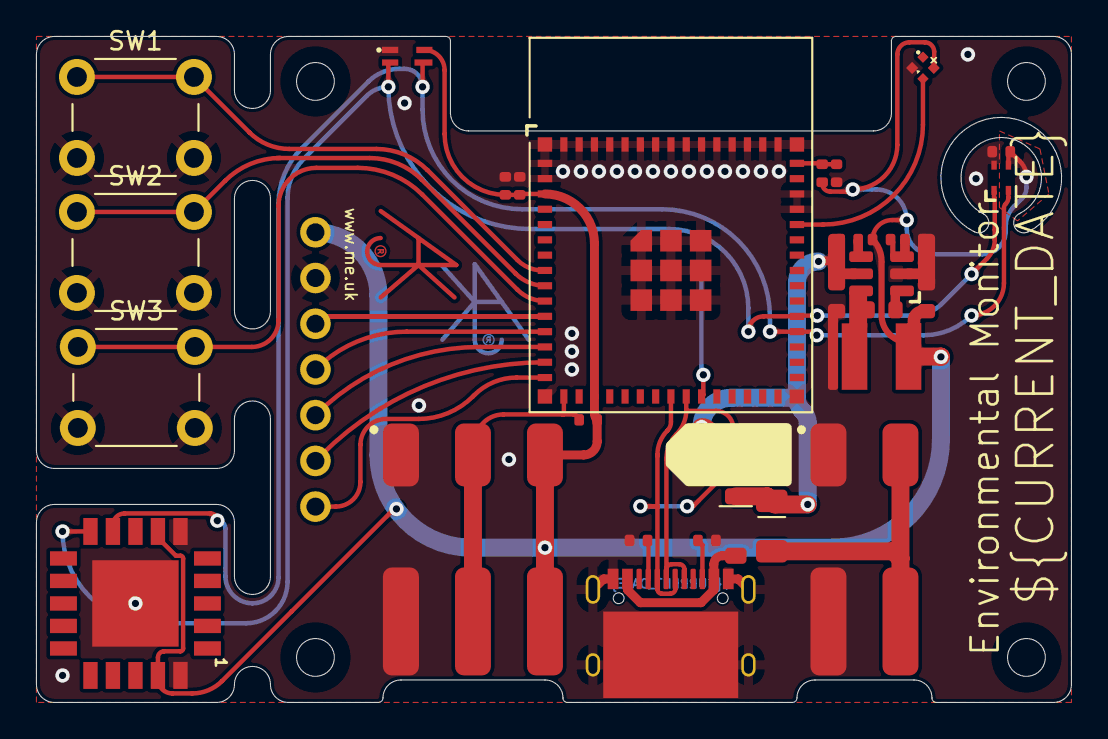
[picture p46: board PCB/EnvMon/EnvMon.kicad_pcb from above]

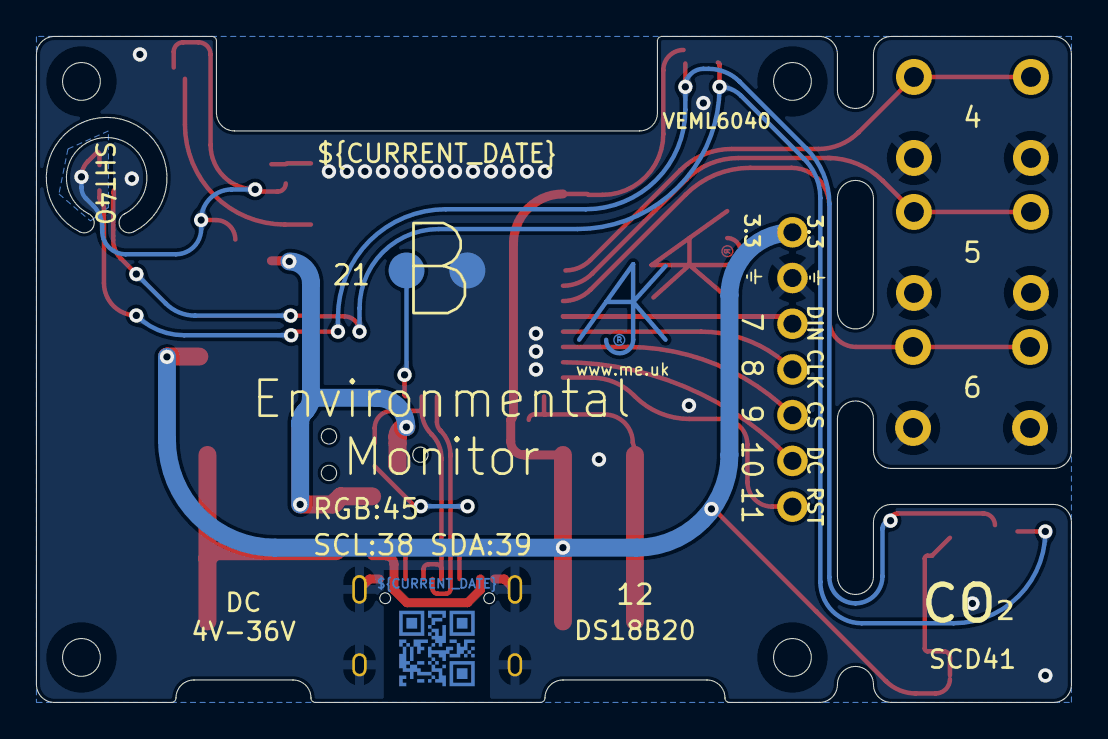
[picture p47: board PCB/EnvMon/EnvMon.kicad_pcb from below]

Board: 4 copper layers, 57.5 x 37.0 mm, 35 parts (3 on the bottom side), 23 nets.
