revk/ESP32-EnvMon/PCB/USBC/USBC.kicad_pcb

## KiCad design PCB/USBC/USBC.kicad_pcb (2025-01-23)

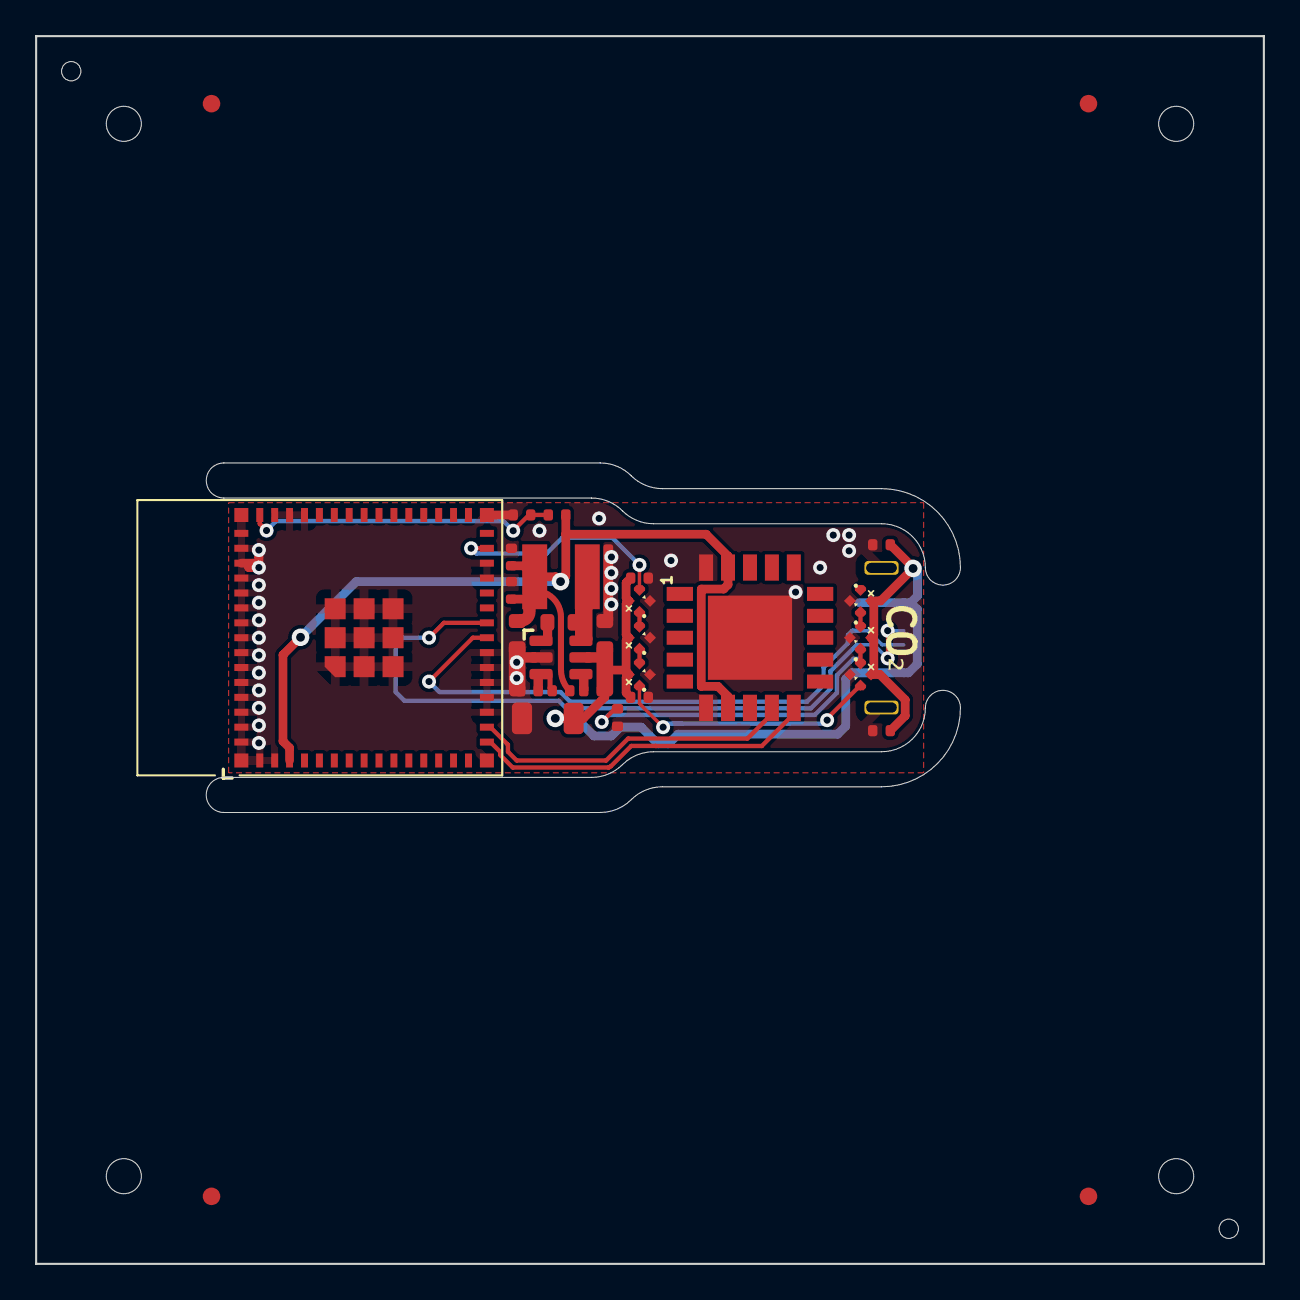
[picture p48: board USBC.kicad_pcb from above]

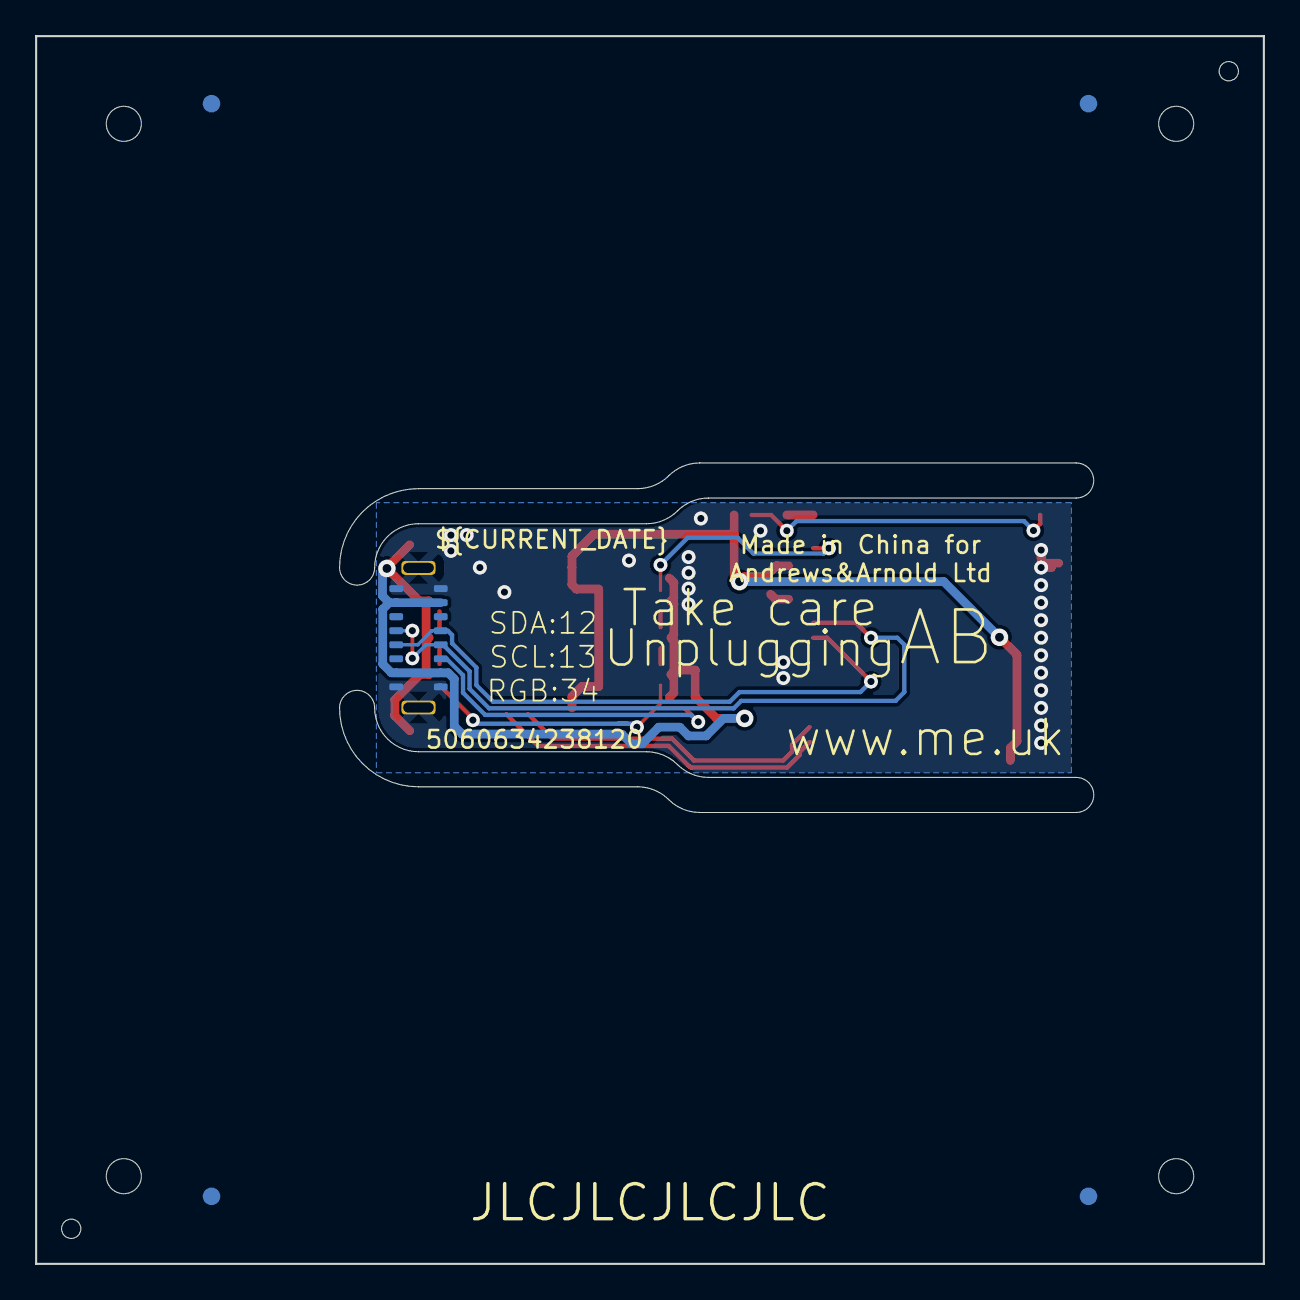
[picture p49: board USBC.kicad_pcb from below]

Board: 2 copper layers, 70.0 x 70.0 mm, 30 parts (2 on the bottom side), 15 nets.

Parts:
C1, C4, C5, C9, C11: 100nF; C_0402
C2: 22uF; C_0402
C3: 1uF; C_0402
C6: 10uF 35V; C_0603_
C7: 10uF 6.3V; C_0603_
C8: 100nF; C_0603_
C10: 100uF 6.3V; C_1206
D1, D2, D3, D4, D5, D6: XL-1010RGBC-WS2812B; SMD1010
J1: USB-C-Plug-V
L2: 10uH; L_4x4_
PCB1: 70x70; PCB7070
R1: 10K; R_0402
R2: 5K1; R_0402
R9: 124k; R_0402_
R10: 39k2; R_0402_
R11: 1M; R_0402_
U2: ESP32-S3-MINI-1
U3: SCD41-D-R1; SCD41
U5: MD8942; SOT-23-6-MD8942
V1, V2: 70; VCUT70N

Connections:
+3.3V: C1.1, C2.1, R1.1, U2.3 (3V3), U3.7 (VDD), U3.19 (VDDH), U5.8 (VOUT)
D+: J1.A6 (D+), J1.B6 (D+), U2.24 (GPIO20)
D-: J1.A7 (D-), J1.B7 (D-), U2.23 (GPIO19)
GND: C1.2, C2.2, C3.2, C4.2, C5.2, C9.2, C10.1, C11.2, D1.3 (-), D2.3 (-), D3.3 (-), D4.3 (-), D5.3 (-), D6.3 (-), J1.A1 (GND), J1.A12 (GND), J1.B1 (GND), J1.B12 (GND), J1.S1 (SHIELD), J1.S2 (SHIELD), R2.2, U2.1 (GND), U2.2 (GND), U2.18 (GPIO14), U2.19 (GPIO15), U2.20 (GPIO16), U2.21 (GPIO17), U2.22 (GPIO18), U2.27 (GPIO47), U2.28 (GPIO33), U2.42 (GND), U2.43 (GND), U2.44 (GPIO46), U2.46 (GND), U2.47 (GND), U2.48 (GND), U2.49 (GND), U2.50 (GND), U2.51 (GND), U2.52 (GND), U2.53 (GND), U2.54 (GND), U2.55 (GND), U2.56 (GND), U2.57 (GND), U2.58 (GND), U2.59 (GND), U2.60 (GND), U2.61 (GND), U2.62 (GND), U2.63 (GND), U2.64 (GND), U2.65 (GND), U3.6 (GND), U3.20 (GND), U3.21 (GND), U5.2 (GND), U5.7 (GND)
LED: D1.4 (I), U2.29 (GPIO34)
unnamed: D1.1 (O), D2.4 (I)
unnamed: D2.1 (O), D3.4 (I)
unnamed: D3.1 (O), D4.4 (I)
unnamed: D4.1 (O), D5.4 (I)
unnamed: D5.1 (O), D6.4 (I)
unnamed: J1.A5 (CC), R2.1
unnamed: C3.1, R1.2, U2.45 (EN)
SCL: U2.17 (GPIO13), U3.9 (SCL)
SDA: U2.16 (GPIO12), U3.10 (SDA)
VBUS: C4.1, C5.1, C9.1, C10.2, C11.1, D1.2 (+), D2.2 (+), D3.2 (+), D4.2 (+), D5.2 (+), D6.2 (+), J1.A4 (VBUS), J1.A9 (VBUS), J1.B4 (VBUS), J1.B9 (VBUS), U5.5 (VIN)
