revk/ESP32-EnvMon/KiCad/OLED.sch

## KiCad design KiCad/OLED.sch (2021-03-10)

Schematic: OLED.sch

Parts:
J1: USB-C; USC16-TR-Round
J2: DC
J3: GPIO; Molex_SPOX_5268-08A_1x08_P2.50mm_Horizontal
M1: D24V5F3-NoSHDN
M2: OLED1.5-RGB
M3: SCD30-4pin
R1, R2: 5K1; R_1206_3216Metric_Pad1.30x1.75mm_HandSolder
R3, R4, R5, R6, R7, R8, R9: NF; R_1206_3216Metric_Pad1.30x1.75mm_HandSolder
U1: FT230XQ; QFN-16-1EP_4x4mm_P0.65mm_EP2.1x2.1mm
U2: ESP32-WROOM-32
