revk/ESP32-EnvMon/(commit log)

2021-03-10 Initial code
    [Case.scad]
2021-03-10 PCB for Environmental Monitor
    [OLED-B_Cu.gbr, OLED-B_Mask.gbr, OLED-B_Paste.gbr, OLED-B_SilkS.gbr, OLED-Edge_Cuts.gbr, OLED-F_Cu.gbr, OLED-F_Mask.gbr, OLED-F_Paste.gbr]
2021-03-10 Put Battery Charger Detect on CBUS1
2021-03-10 Updated CBUS connections
    [EnvMon-B_Cu.gbr, EnvMon-B_Mask.gbr, EnvMon-B_Paste.gbr, EnvMon-B_SilkS.gbr, EnvMon-Edge_Cuts.gbr, EnvMon-F_Cu.gbr, EnvMon-F_Mask.gbr, EnvMon-F_Paste.gbr]
2021-03-10 Moved CO2 to usable GPIOs
    [EnvMon-B_Cu.gbr, EnvMon-B_Mask.gbr, EnvMon-B_Paste.gbr, EnvMon-B_SilkS.gbr, EnvMon-Edge_Cuts.gbr, EnvMon-F_Cu.gbr, EnvMon-F_Mask.gbr, EnvMon-F_Paste.gbr]
2021-03-10 Started work moving to new PCB and SPI
2021-03-11 Started on SPI logic now
    [EnvMon-B_Cu.gbr, EnvMon-B_Mask.gbr, EnvMon-B_Paste.gbr, EnvMon-B_SilkS.gbr, EnvMon-Edge_Cuts.gbr, EnvMon-F_Cu.gbr, EnvMon-F_Mask.gbr, EnvMon-F_Paste.gbr]
2021-03-11 Started working
    [EnvMon-B_Cu.gbr, EnvMon-B_Mask.gbr, EnvMon-B_Paste.gbr, EnvMon-B_SilkS.gbr, EnvMon-Edge_Cuts.gbr, EnvMon-F_Cu.gbr, EnvMon-F_Mask.gbr, EnvMon-F_Paste.gbr]
2021-03-13 Fan posn
2021-03-15 Library update
    [EnvMon.scad]
2021-03-15 Revised case
2021-03-15 Tidy tracks around FT230X
    [EnvMon.kicad_pcb]
2021-03-15 Revised for SCD30 contact
    [EnvMon.kicad_pcb, EnvMon.sch]
2021-03-15 Tweak for DC
    [EnvMon.kicad_pcb]
2021-03-15 Clear antenna more
    [EnvMon.kicad_pcb]
2021-03-15 Move DC connector
    [EnvMon.kicad_pcb]
2021-03-16 STL make
2021-03-16 Fix clear after night
    [Env.c]
2021-03-17 Hole for temp
2021-03-24 Clearer QFN16 for soldering
    [EnvMon-B_Cu.gbr, EnvMon-B_Mask.gbr, EnvMon-B_Paste.gbr, EnvMon-B_SilkS.gbr, EnvMon-Edge_Cuts.gbr, EnvMon-F_Cu.gbr, EnvMon-F_Mask.gbr, EnvMon-F_Paste.gbr]
2021-03-25 Bigger hole
2021-03-25 Missing holes
2021-03-26 Hole for thermometer bigger
2021-03-26 Include built STL files in Git for ease of use.
    [EnvMon-flush-noco2.stl, EnvMon-flush-nooled.stl, EnvMon-flush.stl, EnvMon-noco2.stl, EnvMon-nooled.stl, EnvMon.stl]
2021-03-26 Revised easier to solder footprint
    [EnvMon-B_Cu.gbr, EnvMon-B_Mask.gbr, EnvMon-B_Paste.gbr, EnvMon-B_SilkS.gbr, EnvMon-Edge_Cuts.gbr, EnvMon-F_Cu.gbr, EnvMon-F_Mask.gbr, EnvMon-F_Paste.gbr]
2021-03-26 Tweak tracks
    [EnvMon-B_Cu.gbr, EnvMon-B_Mask.gbr, EnvMon-B_Paste.gbr, EnvMon-B_SilkS.gbr, EnvMon-Edge_Cuts.gbr, EnvMon-F_Cu.gbr, EnvMon-F_Mask.gbr, EnvMon-F_Paste.gbr]
2021-03-27 Way more clearance around regulator pads
    [EnvMon-B_Cu.gbr, EnvMon-B_Mask.gbr, EnvMon-B_Paste.gbr, EnvMon-B_SilkS.gbr, EnvMon-Edge_Cuts.gbr, EnvMon-F_Cu.gbr, EnvMon-F_Mask.gbr, EnvMon-F_Paste.gbr]
2021-03-28 Clearance around FTDI
    [EnvMon-B_Cu.gbr, EnvMon-B_Mask.gbr, EnvMon-B_Paste.gbr, EnvMon-B_SilkS.gbr, EnvMon-Edge_Cuts.gbr, EnvMon-F_Cu.gbr, EnvMon-F_Mask.gbr, EnvMon-F_Paste.gbr]
2021-03-31 Tweak ground fill
    [EnvMon-B_Cu.gbr, EnvMon-B_Mask.gbr, EnvMon-B_Paste.gbr, EnvMon-B_SilkS.gbr, EnvMon-Edge_Cuts.gbr, EnvMon-F_Cu.gbr, EnvMon-F_Mask.gbr, EnvMon-F_Paste.gbr]
2021-04-01 RH and CO₂ for fan
    [EnvMon.kicad_pcb]
2021-04-03 Night cleared fan
2021-04-08 More details on assembly and auto day/night mode
2021-04-15 Fan resent only for on (assume timed off)
2021-05-02 New regulator
    [EnvMon-B_Cu.gbr, EnvMon-B_Mask.gbr, EnvMon-B_Paste.gbr, EnvMon-B_SilkS.gbr, EnvMon-Edge_Cuts.gbr, EnvMon-F_Cu.gbr, EnvMon-F_Mask.gbr, EnvMon-F_Paste.gbr]
2021-05-02 Case needs square corners as OLED has square corners
    [EnvMon-B_Cu.gbr, EnvMon-B_Mask.gbr, EnvMon-B_Paste.gbr, EnvMon-B_SilkS.gbr, EnvMon-Edge_Cuts.gbr, EnvMon-F_Cu.gbr, EnvMon-F_Mask.gbr, EnvMon-F_Paste.gbr]
2021-05-03 Reg tidy
    [EnvMon-B_Cu.gbr, EnvMon-B_Mask.gbr, EnvMon-B_Paste.gbr, EnvMon-B_SilkS.gbr, EnvMon-Edge_Cuts.gbr, EnvMon-F_Cu.gbr, EnvMon-F_Mask.gbr, EnvMon-F_Paste.gbr]
2021-05-03 3d update
    [EnvMon-flush-noco2.stl, EnvMon-flush-nooled.stl, EnvMon-flush.stl, EnvMon-noco2.stl, EnvMon-nooled.stl, EnvMon.kicad_pcb, EnvMon.stl]
2021-05-05 Tweak footprint
    [EnvMon-B_Cu.gbr, EnvMon-B_Mask.gbr, EnvMon-B_Paste.gbr, EnvMon-B_SilkS.gbr, EnvMon-Edge_Cuts.gbr, EnvMon-F_Cu.gbr, EnvMon-F_Mask.gbr, EnvMon-F_Paste.gbr]
2021-05-15 Regulator update
    [EnvMon-B_Cu.gbr, EnvMon-B_Mask.gbr, EnvMon-B_Paste.gbr, EnvMon-B_SilkS.gbr, EnvMon-Edge_Cuts.gbr, EnvMon-F_Cu.gbr, EnvMon-F_Mask.gbr, EnvMon-F_Paste.gbr]
2021-05-23 New regulator layout
    [EnvMon-B_Cu.gbr, EnvMon-B_Mask.gbr, EnvMon-B_Paste.gbr, EnvMon-B_SilkS.gbr, EnvMon-Edge_Cuts.gbr, EnvMon-F_Cu.gbr, EnvMon-F_Mask.gbr, EnvMon-F_Paste.gbr]
2021-05-23 Tweak regulater
    [EnvMon-B_Cu.gbr, EnvMon-B_Mask.gbr, EnvMon-B_Paste.gbr, EnvMon-B_SilkS.gbr, EnvMon-Edge_Cuts.gbr, EnvMon-F_Cu.gbr, EnvMon-F_Mask.gbr, EnvMon-F_Paste.gbr]
2021-05-26 Added LED and date
    [EnvMon-B_Cu.gbr, EnvMon-B_Mask.gbr, EnvMon-B_Paste.gbr, EnvMon-B_SilkS.gbr, EnvMon-Edge_Cuts.gbr, EnvMon-F_Cu.gbr, EnvMon-F_Mask.gbr, EnvMon-F_Paste.gbr]
2021-07-17 Wrong way around display
    [EnvMon-flush-noco2.stl, EnvMon-flush-nooled.stl, EnvMon-flush.stl, EnvMon-noco2.stl, EnvMon-nooled.stl, EnvMon.stl]
2021-07-17 Updated (was wrong way around)
    [EnvMon-flush-noco2.stl, EnvMon-flush-nooled.stl, EnvMon-flush.stl, EnvMon-noco2.stl, EnvMon-nooled-noco2.stl, EnvMon-nooled.stl, EnvMon.stl]
2021-08-04 Move resistors
    [EnvMon-B_Cu.gbr, EnvMon-B_Mask.gbr, EnvMon-B_Paste.gbr, EnvMon-B_SilkS.gbr, EnvMon-Edge_Cuts.gbr, EnvMon-F_Cu.gbr, EnvMon-F_Mask.gbr, EnvMon-F_Paste.gbr]
2021-10-16 Secondary traces (heat/fan)
2021-10-16 Log non heat/fan as well
2021-10-16 Report heat/fan change
2021-10-16 Switch time min for heat and fan
2021-10-16 Better reporting logic when not set for fan or heat
2021-10-16 Reporting if any heating since last report
2021-10-16 Latching heat/fan better
2021-10-18 Handle graphs better when not all traces available
2021-11-03 Power as heat ?
2021-11-09 Power as heat for temp (setoption26 to force when one relay)
2021-12-05 Was reporting too fast
    [Env.c]
2021-12-05 Gradual heatratemC
2021-12-07 Fix slope (again) and min
    [Env.c]
2021-12-30 Kicad 6
    [EnvMon-B_Cu.gbr, EnvMon-B_Mask.gbr, EnvMon-B_Paste.gbr, EnvMon-B_Silkscreen.gbr, EnvMon-Edge_Cuts.gbr, EnvMon-F_Cu.gbr, EnvMon-F_Mask.gbr, EnvMon-F_Paste.gbr]
2021-12-31 More KiCad 6 tweaks
    [EnvMon-B_Cu.gbr, EnvMon-B_Mask.gbr, EnvMon-B_Paste.gbr, EnvMon-B_Silkscreen.gbr, EnvMon-Edge_Cuts.gbr, EnvMon-F_Cu.gbr, EnvMon-F_Mask.gbr, EnvMon-F_Paste.gbr]
2022-01-18 New tasmota power logging tools
2022-01-20 Allows for power factor
2022-01-20 --raw for no power factor logic
2022-01-25 New PSU
    [EnvMon-B_Cu.gbr, EnvMon-B_Mask.gbr, EnvMon-B_Paste.gbr, EnvMon-B_Silkscreen.gbr, EnvMon-Edge_Cuts.gbr, EnvMon-F_Cu.gbr, EnvMon-F_Mask.gbr, EnvMon-F_Paste.gbr]
2022-02-21 Started on new EnvMon2
    [EnvMon2.kicad_pcb, EnvMon2.kicad_sch]
2022-02-21 Making progress
    [EnvMon2-B_Cu.gbr, EnvMon2-B_Mask.gbr, EnvMon2-B_Paste.gbr, EnvMon2-B_Silkscreen.gbr, EnvMon2-Edge_Cuts.gbr, EnvMon2-F_Cu.gbr, EnvMon2-F_Mask.gbr, EnvMon2-F_Paste.gbr]
2022-02-22 Missed a pull up
    [EnvMon2-B_Cu.gbr, EnvMon2-B_Mask.gbr, EnvMon2-B_Paste.gbr, EnvMon2-B_Silkscreen.gbr, EnvMon2-Edge_Cuts.gbr, EnvMon2-F_Cu.gbr, EnvMon2-F_Mask.gbr, EnvMon2-F_Paste.gbr]
2022-02-23 Clean footprint
    [EnvMon2-B_Cu.gbr, EnvMon2-B_Mask.gbr, EnvMon2-B_Paste.gbr, EnvMon2-B_Silkscreen.gbr, EnvMon2-Edge_Cuts.gbr, EnvMon2-F_Cu.gbr, EnvMon2-F_Mask.gbr, EnvMon2-F_Paste.gbr]
2022-03-07 Not working - stupid OpenSCAD
    [EnvMon2.stl]
2022-03-07 Starting new code
    [EnvMon-flush-noco2.stl, EnvMon-flush-nooled.stl, EnvMon-flush.stl, EnvMon-noco2.stl, EnvMon-nooled-noco2.stl, EnvMon-nooled.stl, EnvMon.stl, EnvMon2-nooled.stl]
2022-03-07 Started on SCD41
    [EnvMon2.stl]
2022-03-08 New case
    [EnvMon-flush.stl, EnvMon-noco2.stl, EnvMon-nooled.stl, EnvMon.stl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]
2022-03-09 New 3D
    [EnvMon.stl, EnvMon2-noco2.stl, EnvMon2.stl]
2022-03-09 Changed artwork for clearances
    [EnvMon-flush-noco2.stl, EnvMon-flush-nooled.stl, EnvMon-flush.stl, EnvMon-noco2.stl, EnvMon-nooled-noco2.stl, EnvMon-nooled.stl, EnvMon.stl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]
2022-03-10 Tidy 3D
    [EnvMon2-flush-nooled.stl, EnvMon2-flush.stl, EnvMon2-noco2.stl, EnvMon2-nooled.stl, EnvMon2.stl]
2022-03-11 DRC tweak
    [EnvMon2-flush-nooled.stl, EnvMon2-flush.stl, EnvMon2-noco2.stl, EnvMon2-nooled.stl, EnvMon2.kicad_pcb, EnvMon2.stl]
2022-03-19 LED and stuff
2022-03-20 Smaller holes
    [EnvMon-B_Cu.gbr, EnvMon-B_Mask.gbr, EnvMon-B_Paste.gbr, EnvMon-B_Silkscreen.gbr, EnvMon-Edge_Cuts.gbr, EnvMon-F_Cu.gbr, EnvMon-F_Mask.gbr, EnvMon-F_Paste.gbr]
2022-03-20 Change to M2 screws
    [EnvMon2-B_Cu.gbr, EnvMon2-B_Mask.gbr, EnvMon2-B_Paste.gbr, EnvMon2-B_Silkscreen.gbr, EnvMon2-Edge_Cuts.gbr, EnvMon2-F_Cu.gbr, EnvMon2-F_Mask.gbr, EnvMon2-F_Paste.gbr]
2022-03-20 Fix heat report
2022-03-29 Fix display lag after night/message, and fix damping on SCD41
    [Env.c]
2022-03-30 D'Oh, summer time fix broke end of day
    [envgraph.c]
2022-04-08 Shorter reporting impacted graph
    [envgraph.c]
2022-04-08 Silly bug - not sending control
    [Env.c]
2022-04-10 Tidy GPIO usage for buttons
    [EnvMon2-B_Cu.gbr, EnvMon2-B_Mask.gbr, EnvMon2-B_Paste.gbr, EnvMon2-B_Silkscreen.gbr, EnvMon2-Edge_Cuts.gbr, EnvMon2-F_Cu.gbr, EnvMon2-F_Mask.gbr, EnvMon2-F_Paste.gbr]
2022-04-15 Negative power
2022-04-19 Fix per device
2022-04-29 Trace for two level
2022-05-20 Moved switches and sensor to line up with display better.
    [EnvMon2-B_Cu.gbr, EnvMon2-B_Mask.gbr, EnvMon2-B_Paste.gbr, EnvMon2-B_Silkscreen.gbr, EnvMon2-Edge_Cuts.gbr, EnvMon2-F_Cu.gbr, EnvMon2-F_Mask.gbr, EnvMon2-F_Paste.gbr]
2022-05-21 Cleaner models
    [EnvMon2-flush-nooled.stl, EnvMon2-flush.stl, EnvMon2-noco2.stl, EnvMon2-nooled.stl, EnvMon2.stl]
2022-05-21 Tidy STL for tweaked PCB
    [EnvMon2-B_Cu.gbr, EnvMon2-B_Mask.gbr, EnvMon2-B_Paste.gbr, EnvMon2-B_Silkscreen.gbr, EnvMon2-Edge_Cuts.gbr, EnvMon2-F_Cu.gbr, EnvMon2-F_Mask.gbr, EnvMon2-F_Paste.gbr]
2022-05-23 Reworked, 4mm joins between parts
    [EnvMon2-B_Cu.gbr, EnvMon2-B_Mask.gbr, EnvMon2-B_Paste.gbr, EnvMon2-B_Silkscreen.gbr, EnvMon2-Edge_Cuts.gbr, EnvMon2-F_Cu.gbr, EnvMon2-F_Mask.gbr, EnvMon2-F_Paste.gbr]
2022-06-04 Fan done
2022-06-09 Change GPIo for button1
    [EnvMon2.kicad_pcb, EnvMon2.kicad_sch]
2022-06-11 Tweak casework
    [EnvMon2-nooled.stl, EnvMon2.kicad_pcb]
2022-06-11 Tidy casework
    [EnvMon2-flush-nooled.stl, EnvMon2-flush.stl, EnvMon2-noco2.stl, EnvMon2-nooled.stl, EnvMon2.stl]
2022-06-11 More tweaks
    [EnvMon2-nooled.stl, EnvMon2.kicad_pcb]
2022-06-28 Updated regulator
    [EnvMon2-B_Cu.gbr, EnvMon2-B_Mask.gbr, EnvMon2-B_Paste.gbr, EnvMon2-B_Silkscreen.gbr, EnvMon2-Edge_Cuts.gbr, EnvMon2-F_Cu.gbr, EnvMon2-F_Mask.gbr, EnvMon2-F_Paste.gbr]
2022-10-04 Some PCB rework in progress
    [EnvMon2.kicad_pcb, EnvMon2.kicad_sch]
2022-10-05 Revised PCB for light sensor
    [EnvMon2-B_Cu.gbr, EnvMon2-B_Mask.gbr, EnvMon2-B_Paste.gbr, EnvMon2-B_Silkscreen.gbr, EnvMon2-Edge_Cuts.gbr, EnvMon2-F_Cu.gbr, EnvMon2-F_Mask.gbr, EnvMon2-F_Paste.gbr]
2022-10-06 Right angle
    [EnvMon2-B_Cu.gbr, EnvMon2-B_Mask.gbr, EnvMon2-B_Paste.gbr, EnvMon2-B_Silkscreen.gbr, EnvMon2-Edge_Cuts.gbr, EnvMon2-F_Cu.gbr, EnvMon2-F_Mask.gbr, EnvMon2-F_Paste.gbr]
2022-10-06 Light sensor
    [EnvMon2-flush-nooled.stl, EnvMon2-flush.stl]
2022-11-28 Minor tweaks
    [EnvMon2-B_Cu.gbr, EnvMon2-B_Mask.gbr, EnvMon2-B_Paste.gbr, EnvMon2-B_Silkscreen.gbr, EnvMon2-Edge_Cuts.gbr, EnvMon2-F_Cu.gbr, EnvMon2-F_Mask.gbr, EnvMon2-F_Paste.gbr]
2022-12-19 Update 1.6mm for now
    [EnvMon2-flush-nooled.stl, EnvMon2-flush.stl, EnvMon2-noco2.stl, EnvMon2-nooled.stl, EnvMon2.stl]
2022-12-19 More light
    [EnvMon2-flush-nooled.stl, EnvMon2-flush.stl, EnvMon2-noco2.stl, EnvMon2-nooled.stl, EnvMon2.stl]
2022-12-26 Button test
2022-12-26 Button test working
2022-12-31 Loss of wifi should not reset SCD41, that is silly
    [Env.c]
2023-01-01 Better DS18B20 error handling
    [Env.c]
2023-01-01 Fix buttons
2023-01-05 PCB files
2023-01-10 New structure#
    [EnvMon-B_Cu.gbr, EnvMon-B_Mask.gbr, EnvMon-B_Paste.gbr, EnvMon-B_Silkscreen.gbr, EnvMon-Edge_Cuts.gbr, EnvMon-F_Cu.gbr, EnvMon-F_Mask.gbr, EnvMon-F_Paste.gbr]
2023-01-10 Production files, not finished
    [EnvMon2.kicad_pcb, bom.csv, designators.csv, positions.csv]
2023-01-10 Revised production files
    [EnvMon2.kicad_pcb, EnvMon2.kicad_sch, bom.csv, positions.csv]
2023-01-10 LED pin silkscreen fix
    [EnvMon2.kicad_pcb]
2023-01-11 Production file update
    [EnvMon2.kicad_pcb, EnvMon2.kicad_sch, positions.csv]
2023-01-11 Resistor update for LED
    [EnvMon2.kicad_pcb, EnvMon2.kicad_sch, bom.csv]
2023-01-20 Extra diode
    [EnvMon2.kicad_pcb, EnvMon2.kicad_sch, bom.csv, designators.csv, positions.csv]
2023-01-21 Fixes #2 Fixes #3
    [Env.c, icons.h]
2023-01-21 icons for rad/fan only if controlling them
2023-01-21 Log icon and add extractor fan icon
2023-01-21 Power as an icon
2023-01-23 heat temp forecast logic
2023-01-28 Icons for slave or antifreeze meaning not heating or not cooling
2023-04-05 Tweak connectors
    [EnvMon2.kicad_pcb, EnvMon2.kicad_sch, bom.csv]
2023-04-29 New PCB with Sensitron SHT40 on board
    [EnvMon2-flush-nooled.scad, EnvMon2-flush-nooled.stl, EnvMon2-flush.scad, EnvMon2-flush.stl, EnvMon2-noco2.scad, EnvMon2-noco2.stl, EnvMon2-nooled.scad, EnvMon2-nooled.stl]
2023-04-29 Started EnvHT
    [EnvHT.kicad_pcb, EnvHT.kicad_sch, EnvMon2.kicad_pcb, EnvMon2.kicad_sch, bom.csv, designators.csv, positions.csv]
2023-04-29 Tracked EnvHT
    [EnvHT.kicad_pcb, EnvHT.kicad_sch, bom.csv, designators.csv, positions.csv]
2023-05-12 Screw adjust
    [EnvHT.kicad_pcb, EnvHT.scad, EnvHT.stl, bom.csv, designators.csv, positions.csv]
2023-05-12 Change default to match schematic
2023-05-12 Damn screws
    [EnvHT.scad, EnvHT.stl]
2023-06-01 Cap chanmge
    [EnvHT.kicad_pcb, EnvHT.kicad_sch, bom.csv, positions.csv]
2023-06-18 Silk and change VEML
    [EnvMon2.kicad_pcb, EnvMon2.kicad_sch, bom.csv, designators.csv, positions.csv]
2023-08-10 S3 board basic tracking started
    [EnvMon.csv, EnvMon.kicad_pcb, EnvMon.kicad_sch, EnvMon2-flush-nooled.scad, EnvMon2-flush-nooled.stl, EnvMon2-flush.scad, EnvMon2-flush.stl, EnvMon2-noco2.scad]
2023-08-10 Not working on S3
    [Env.c]
2023-08-10 Pretty tracks
    [EnvMon.kicad_pcb, EnvMon.kicad_sch, bom.csv, designators.csv, positions.csv]
2023-08-12 One board
    [EnvMon.kicad_pcb, EnvMon.kicad_sch, EnvMon2.csv, EnvMon2.kicad_pcb, EnvMon2.kicad_sch, bom.csv, designators.csv, positions.csv]
2023-08-19 New reg
    [EnvMon.kicad_pcb, positions.csv]
2023-08-31 New design 3D case
    [EnvHT.kicad_pcb, EnvHT.scad, EnvHT.stl, EnvMon.scad, EnvMon.stl]
2023-10-09 Simpler flush case
2023-10-09 Include in build
    [EnvHT.scad]
2023-10-15 WS2812B LED
    [EnvMon.kicad_pcb, EnvMon.kicad_sch, bom.csv, designators.csv, positions.csv]
2023-12-19 Start new PCB
    [USBC.kicad_pcb, USBC.kicad_sch, bom.csv, designators.csv, positions.csv]
2023-12-27 Clear defaults and fix ilk
    [EnvHT.scad, EnvHT.stl, EnvMon-flush.scad, EnvMon-noco2.scad, EnvMon-noco2.stl, EnvMon-nooled.scad, EnvMon-nooled.stl, EnvMon.scad]
2023-12-30 More LEDs
    [USBC.kicad_pcb, USBC.kicad_sch, bom.csv, designators.csv, positions.csv]
2023-12-30 USBC case done
    [EnvHT.scad, EnvHT.stl, EnvMon-flush-noco2.scad, EnvMon-flush-nooled.scad, EnvMon-flush-nooled.stl, EnvMon-flush.scad, EnvMon-flush.stl, EnvMon-noco2.scad]
2024-08-11 New plugs
    [EnvMon.kicad_pcb, EnvMon.kicad_sch, USBC.kicad_pcb, USBC.kicad_sch, bom.csv, designators.csv, positions.csv]
2024-09-18 Library update fixed the issue
    [Env.c]
2024-09-24 CO2 LEDs
2024-11-12 LED tweaks
2025-01-23 PCB Update
    [EnvHT.kicad_pcb, EnvHT.kicad_sch, EnvMon.kicad_pcb, EnvMon.kicad_sch, USBC.kicad_pcb, USBC.kicad_sch]
2025-04-13 Started Env2
    [EnvMon.kicad_pcb, EnvMon.kicad_sch, bom.csv, designators.csv, positions.csv]
2025-04-13 Tracked and SS
    [EnvMon.kicad_pcb, EnvMon.kicad_sch, bom.csv, designators.csv, positions.csv]
2025-04-14 Tweaks and render
    [EnvMon.kicad_pcb, EnvMon.kicad_sch, designators.csv, positions.csv]
2025-04-14 Pressure sensor
    [EnvMon.kicad_pcb, EnvMon.kicad_sch, bom.csv, designators.csv, positions.csv]
2025-04-14 Silk screen
    [EnvMon.kicad_pcb]
2025-04-20 New board
    [EnvMon.kicad_pcb, EnvMon.kicad_sch, bom.csv, designators.csv, positions.csv]
2025-04-20 Tidy up
    [EnvMon.kicad_pcb]
2025-04-21 Render button
    [EnvMon.kicad_pcb]
2025-04-24 As ordered
    [EnvHT.scad, EnvHT.stl, EnvMon-flush-noco2.scad, EnvMon-flush-nooled.scad, EnvMon-flush-nooled.stl, EnvMon-flush.scad, EnvMon-flush.stl, EnvMon-noco2.scad]
2025-04-25 Moved to FaikinRemote project
    [Env2.scad, Env3.scad, EnvMon.kicad_pcb, EnvMon.kicad_sch, EnvMon.scad, EnvMon.stl, bom.csv, designators.csv]
2025-04-25 New case work
    [EnvHT.scad, EnvHT.stl, EnvMon-flush-noco2.scad, EnvMon-flush-nooled.scad, EnvMon-flush-nooled.stl, EnvMon-flush.scad, EnvMon-flush.stl, EnvMon-noco2.scad]
2025-04-26 Reworked case
    [EnvHT.scad, EnvHT.stl, EnvMon-flush-noco2.scad, EnvMon-flush-nooled.scad, EnvMon-flush-nooled.stl, EnvMon-flush.scad, EnvMon-flush.stl, EnvMon-noco2.scad]
2025-04-27 New case options
    [Env2-BP24.scad, Env2-BP24.stl, EnvHT.scad, EnvHT.stl, EnvMon-flush-noco2.scad, EnvMon-flush-nooled.scad, EnvMon-flush-nooled.stl, EnvMon-flush.scad]
2025-04-28 Top cover
    [Env2-Cover2.scad, Env2-Cover2.stl]
2025-04-28 Tidy new case cover
    [Env2-Cover2.stl, Env2-Cover2CO2.scad, Env2-Cover2CO2.stl, EnvHT.scad, EnvHT.stl, EnvMon-flush-noco2.scad, EnvMon-flush-nooled.scad, EnvMon-flush-nooled.stl]
2025-05-03 Reworked 3D
    [Env2-BP24DS.scad, Env2-BP24DS.stl, Env2-Cover.scad, Env2-Cover.stl, Env2-CoverCO2.scad, Env2-CoverCO2.stl, Env2-CoverDS.scad, Env2-CoverDS.stl]
2025-05-03 Log heat/fan
2025-05-03 Space for leads
    [Env2-BP24DS.scad]
2025-05-05 More cases
    [Env2-BP.scad, Env2-BP.stl, Env2-BPCO2DS.scad, Env2-BPCO2DS.stl, Env2-BPDS.scad, Env2-BPDS.stl, EnvHT.scad, EnvHT.stl]
2025-10-10 New LEDs
    [EnvHT.kicad_sch, blankplate.scad]
